francisconroy/NU-Racing---ETC-and-manumatic-Electronics/starkey/solenoid_driver-master/pcb/dual_half_bridge_driver/reminder_list.txt

-FUSES - 12v & (SMD and reverse polarity)
-1 or 2 drivers per board
-Heatsink orientation
-Connectors (footprint)
-Indicator LEDS
-Undervoltage lockout
