francisconroy/NU-Racing---ETC-and-manumatic-Electronics/pinout diagram.pptx

CU | OP

ECU5V
ECUGND
ECUTPS

ECU5V
ECUGND
ECUTPS
3V3
AGND
P17
3V3
AGND
P14
3V3
AGND
P15

BAT GND
BAT POS

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
P3 | P4

## Slide 2

P17 - SPARE | P18 - NEUT | GND

5V MOTEC
SIG MOTEC
GND MOTEC

P11 - UP
P12 - DN
GND

GND
P20 ROT 1
P21 ROT 2
P22 ROT 3
P23 MODE BTN

BV+
BGND

FLT NET
P19 SIG – TEMP1
P7 - UNUSED
P10 – 1INB
P9 – 1PWM
P8 – 1INA
GND
5V

FLT NET
P16 SIG – TEMP2
P2 - UNUSED
P5 – 2PWM
P4 – 2INB
P3 – 2INA
GND
5V

P6 - CLUTCH
GND

3V3
AGND
P14 - ANGLE

GND | P1 | P0
