francisconroy/NU-Racing---ETC-and-manumatic-Electronics/bill_of_materials2.xlsx

Sheet: Sheet1
IC's | Rating | Value | Quantity | Supplier | Ordering number | Price | Subtotal | Notes
gate driver |  | ir2114 | 2 | element14 | 1498177 | 5.71 | 11.42
mosfet |  | irfp1405pbf | 2 | element14 | 2062073 | 5.48 | 10.96 | AUIRFP1405Pbf (automotive rated)
mosfet | 80amp, 30v pmos | IPP80P03P4L-04 | 1 | element14 | 2443406 | 3.47 | 3.47 |  | Total
temp. sensor |  | lmt87 | 1 | element14 | 2432145 | 3.43 | 3.43 |  | 18985161.89
npn |  | MMBT2222ALT1G | 6 | element14 | 1459098 | 0.165 | 0.99
pnp |  | MMBT2907ALT1G | 5 | element14 | 1459099 | 0.165 | 0.825 |  | NOTES:
fuse | 0.5amp | 0437.500WR. | 2 | element14 | 1822807 | 0.52 | 1.04 | Ampage rating could possibly be lowered | Yellow implies to be filled
zener | 21v | SMAZ20-TP | 1 | element14 | 1924463 | 0.916 | 0.916 | D1 | All quantities need to be doubled
zener | 6v | 1SMA5920BT3G | 2 | element14 | 1431142 | 0.841 | 1.682 | D3,D2
zener | 10v | BZG03C10-TR | 1 | element14 | 6475802 | 0.634 | 0.634 | D7
regulator | 5v | KA7805ERTF | 1 | element14 | 1786484 | 1.5 | 1.5
pcb crimp tab | 6.35x0.81 | 726386-2 | 10 | element14 | 4215618 | 0.26 | 2.6
header | 10 way 0.1” | 1-640454-0 | 2 | element14 | 588544 | 0.879 | 1.758 | http://au.element14.com/te-connectivity-amp/1-640454-0/product-range-mta-100-series/dp/588544
header | 6 way 0.1” |  | 2 | element14 | 588611 | 0.56 | 1.12 | http://au.element14.com/te-connectivity-amp/640456-6/product-range-mta-100-series/dp/588611?ost=588611
connector | 6 way 0.1” |  | 2 | element14 | 1363277 | 0.73 | 1.46
connector | 10 way 0.1” | 4-643815-0 | 2 | element14 | 1296705 | 1.52 | 3.04
optocoupler | 4n25 | 4N25(SHORT) | 5 | element14 | 1225849 | 0.227 | 1.135
diodes | 40v, 3A schottky | SS34A | 3 | element14 | 1843500 | 0.431 | 1.293
Resistors |  |  |  |  |  |  | 0
270 | 1206 |  | 4 | element14 | 9336257 (http://au.element14.com/multicomp/mc0125w12061270r/resistor-270r-0-125w-1-1206/dp/9336257) |  | 0
330 | 1206 |  | 2 | element14 | 1632563 (http://au.element14.com/multicomp/mc1206s4f3300t5e/thick-film-resistor-330-ohm-250mw/dp/1632563) |  | 0
4.7k | 1206 |  | 4 | element14 | 1809484 (http://au.element14.com/koa-spear-electronics/rk73b2bttd472j/resistor-1206-4k7-ohm-5/dp/1809484) |  | 0
100 | 1206 |  | 2 | element14 | 1632521 (http://au.element14.com/multicomp/mc1206s4f1000t5e/thick-film-resistor-100-ohm-250mw/dp/1632521) |  | 0
22 | 1206 |  | 4 | element14 | 1152831 (http://au.element14.com/vishay-dale/crcw120622r0fkea/thick-film-resistor-22-ohm-250mw/dp/1152831) |  | 0
1k | 1206 |  | 9 | element14 | 1811972 (http://au.element14.com/koa-spear-electronics/rk73h2bttd1001f/resistor-1206-1k-ohm-1/dp/1811972) |  | 0
10k | 1206 |  | 8 | element14 | 1632523 (http://au.element14.com/multicomp/mc1206s4f1002t5e/thick-film-resistor-10kohm-250mw/dp/1632523) |  | 0
 |  |  |  |  |  |  | 0
Caps |  |  |  |  |  |  | 0
100n | 1206 | 12061C104KAT2A | 10 | element14 | 1327703 | 0.194 | 1.94 | actual qty 8, MOQ is 5
1n | 1206 | MC1206B102K202CT | 1 | element14 | 1855909 | 0.252 | 0.252
1u | 1206 | C3216X7R1E105K085AA | 3 | element14 | 2346954 | 0.08 | 0.24
0.68u | 250v | B32652A3684J000 | 1 | element14 | 1200778 | 1.86 | 1.86 | pulse rated
470n | 1206 | 12063C474KAT2A | 5 | element14 | 1327718 | 0.184 | 0.92 | MOQ is 5, actual qty 1
 |  |  |  |  |  |  | 0
Hardware |  |  |  |  |  |  | 0
mica pad | to-247 |  | 3 | element14 | 1577101 | 2.13 | 6.39
standoffs | M3x10 |  | 10 | element14 | 1898510 (http://au.element14.com/richco/htsa-m3-10-1/aluminium-spacer-f-f-m3-10mm-high/dp/1898510) | 0.272 | 18985100
screws | M3x20 |  | 3 | element14 | 1419295 (http://au.element14.com/tr-fastenings/m320-psstmcz100/screw-slt-pan-steel-bzp-m3x20/dp/1419295) |  | 0
screws | M3x6 |  | 4 | element14 | 1419986 |  | 0
insulated washer | M3.5 outer, M3 Inner | 7721-7PPSG | 3 | element14 | 1703100 | 0.337 | 1.011
nuts | M3 |  | 100 | element14 | 1419447

Sheet: output
PN | QTY | DESC | MULTIPLIER
 | 0 | Resistors |  | 0 | ',0,Resistors'
0 | 0 | 0 |  | 0 | '0,0,0'
0 | 0 | Caps |  | 0 | '0,0,Caps'
0 | 0 | 0 |  | 0 | '0,0,0'
0 | 0 | Hardware |  | 0 | '0,0,Hardware' | '
0 | 0 | 0 |  | 0 | '0,0,0'
0 | 0 | 0 |  | 0 | '0,0,0'
0 | 0 | 0 |  |  | '0,,0'
0 | 0 | 0
2443406 | 1 | mosfet | 2 | 2 | 2443406,2,mosfet
2432145 | 1 | temp. sensor | 2 | 2 | 2432145,2,temp. sensor
1924463 | 1 | zener | 2 | 2 | 1924463,2,zener
6475802 | 1 | zener | 2 | 2 | 6475802,2,zener
1786484 | 1 | regulator | 2 | 2 | 1786484,2,regulator
1855909 | 1 | 1n | 2 | 2 | 1855909,2,1n
1200778 | 1 | 0.68u | 2 | 2 | 1200778,2,0.68u
1498177 | 2 | gate driver | 2 | 4 | 1498177,4,gate driver
2062073 | 2 | mosfet | 2 | 4 | 2062073,4,mosfet
1822807 | 2 | fuse | 2 | 4 | 1822807,4,fuse
1431142 | 2 | zener | 2 | 4 | 1431142,4,zener
588544 | 2 | header | 2 | 4 | 588544,4,header
588611 | 2 | header | 2 | 4 | 588611,4,header
1363277 | 2 | connector | 2 | 4 | 1363277,4,connector
1296705 | 2 | connector | 2 | 4 | 1296705,4,connector
1632563 | 2 | 330 | 3 | 6 | 1632563,6,330
1632521 | 2 | 100 | 3 | 6 | 1632521,6,100
1843500 | 3 | diodes | 2 | 6 | 1843500,6,diodes
2346954 | 3 | 1u | 2 | 6 | 2346954,6,1u
1577101 | 3 | mica pad | 2 | 6 | 1577101,6,mica pad
1419295 | 3 | screws | 2 | 6 | 1419295,6,screws
1703100 | 3 | insulated washer | 2 | 6 | 1703100,6,insulated washer
9336257 | 4 | 270 | 3 | 12 | 9336257,12,270
1809484 | 4 | 4.7k | 3 | 12 | 1809484,12,4.7k
1152831 | 4 | 22 | 3 | 12 | 1152831,12,22
1419986 | 4 | screws | 2 | 8 | 1419986,8,screws
1459099 | 5 | pnp | 2 | 10 | 1459099,10,pnp
1225849 | 5 | optocoupler | 2 | 10 | 1225849,10,optocoupler
1327718 | 5 | 470n | 2 | 10 | 1327718,10,470n
1459098 | 6 | npn | 2 | 12 | 1459098,12,npn
1632523 | 8 | 10k | 3 | 24 | 1632523,24,10k
1811972 | 9 | 1k | 3 | 27 | 1811972,27,1k
4215618 | 10 | pcb crimp tab | 2 | 20 | 4215618,20,pcb crimp tab
1327703 | 10 | 100n | 2 | 20 | 1327703,20,100n
1898510 | 10 | standoffs | 2 | 20 | 1898510,20,standoffs
1419447 | 100 | nuts | 2 | 200 | 1419447,200,nuts
