francisconroy/NU-Racing---ETC-and-manumatic-Electronics/ETC_GS_Combined_BOM.xlsx

Sheet: pivot
Sum of qty
pkg | value | Total | TOTAL_REQ | ON_HAND | SUPPLIER# | PRICE PER UNIT | NOTE | SUPPLIER
1X10_LOCK | (blank) | 2 | 2 | 0 | 588544 | 0.915 | MTA-100 conn | E14
1X12_LOCK | P0-11 | 2 | 0
 | P12-23 | 2 | 0
C1206 | 0.1uF | 17 | 10 | 18 | 1867950 (http://au.element14.com/avx/12062c104kat2a/cap-mlcc-x7r-100nf-200v-1206/dp/1867950) | 0.036 |  | E14
 | 10n | 2 | 4 |  | 4801880 | 0.028 |  | E14
 | 1nF | 5 | 10 |  | 1759337 (http://au.element14.com/multicomp/mc1206b102k500ct/cap-mlcc-x7r-1nf-50v-1206/dp/1759337) | 0.074 |  | E14
 | 1uF | 2 | 4 |  | 1759438 | 0.018 |  | E14
DIP08 | LM358 | 1 | 2 |  | SF-COM-09456 | 1.46 | Through little bird elec | LittleBird
DISP_CONN | DISP_CONN | 1 | 1 |  | 588600 (http://au.element14.com/te-connectivity-amp/640456-5/product-range-mta-100-series/dp/588600) | 0.428 | display header | E14
DO214BA | 0 | 1 | 4 |  | 1687497 (http://au.element14.com/multicomp/1sma4740/diode-zener-10v-1w/dp/1687497) | 0.56 | 10V ZENER | E14
 | (blank) | 1
DO41-10 | 1N4004 | 1 | 2 |  | 1383892 (http://au.element14.com/nte-electronics/1n4004/standard-diode-1a-400v-do-41/dp/1383892) | 0.067 |  | E14
E5-8,5 | 47uF | 1 | 2 |  | 2346630 (http://au.element14.com/rubycon/200px47mefc10x20/product-range-px-series/dp/2346630) | 0.989 |  | E14
HSOP16-P-300-1.00 | TB6559FG | 1 | 0
JEDECDO-214AB | LNBTVS | 2 | 4 |  | 1749287 | 1.88 |  | E14
LED-1206 | FUSE HERE | 1 | 10 |  | 2414111 (http://au.element14.com/panasonic-electronic-components/erb-rg0r50v/fuse-500ma-63vdc-fast-acting-1206/dp/2414111) | 0.262 | FUSE 500mA for LM7805 | E14
M1206 | 2k | 1 | 2 |  | 2333590 | 0.1 |  | E14
 | 3k | 1 | 2 |  | 1646697 (http://au.element14.com/multicomp/mc1206s4f3001t5e/resistor-thick-film-3kohm-0-25w/dp/1646697) | 0.0034 |  | E14
MOLEX-1X3_LOCK | SER | 2 | 4 |  | 588581 (http://au.element14.com/te-connectivity-amp/640456-3/product-range-mta-100-series/dp/588581) | 0.331 | MTA-100 serial | E14
R1206 | 15 | 2 | 4 |  | 2332114 (http://au.element14.com/te-connectivity/crgh1206f15r/resistor-power-15r-0-5w-1-1206/dp/2332114) | 0.07 |  | E14
 | 27 | 2 | 4 |  | 2332118 (http://au.element14.com/te-connectivity/crgh1206f27r/resistor-power-27r-0-5w-1-1206/dp/2332118) | 0.07 |  | E14
 | 33 | 1 | 2 |  | 1692544 (http://au.element14.com/vishay-draloric/crcw120633r0fkea/product-range-aec-q200-crcw-series/dp/1692544) | 0.04 |  | E14
 | 39 | 2 | 4 |  | 2332120 (http://au.element14.com/te-connectivity/crgh1206f39r/resistor-power-39r-0-5w-1-1206/dp/2332120) | 0.07 |  | E14
 | 240 | 1 | 2 |  | 1630578 (http://au.element14.com/multicomp/mc1206s4f2400t5e/thick-film-resistor-240-ohm-250mw/dp/1630578) | 0.009 |  | E14
 | 270 | 6 | 12 |  | 1470003 (http://au.element14.com/vishay-draloric/crcw1206270rfkea/product-range-aec-q200-crcw-series/dp/1470003) | 0.04 |  | E14
 | 680 | 1 | 2 |  | 1632597 (http://au.element14.com/multicomp/mc1206s4f6800t5e/thick-film-resistor-680-ohm-250mw/dp/1632597) | 0.018 |  | E14
 | 10k | 15 | 30 |  | 1632523 (http://au.element14.com/multicomp/mc1206s4f1002t5e/thick-film-resistor-10kohm-250mw/dp/1632523) | 0.008 |  | E14
 | 1k | 8 | 16 |  | 1811972 (http://au.element14.com/koa-spear-electronics/rk73h2bttd1001f/resistor-1206-1k-ohm-1/dp/1811972) | 0.021 |  | E14
 | 20k | 6 | 12 |  | 1632543 (http://au.element14.com/multicomp/mc1206s4f2002t5e/thick-film-resistor-20kohm-250mw/dp/1632543) | 0.009 |  | E14
 | 4.7k | 7 | 14 |  | 1632579 (http://au.element14.com/multicomp/mc1206s4f4701t5e/thick-film-resistor-4-7kohm-250mw/dp/1632579) | 0.022 |  | E14
 | 40k | 2 | 4 |  | 2142268 (http://au.element14.com/multicomp/mc0125w1206140k2/resistor-40k2-0-125w-1-1206/dp/2142268) | 0.02 |  | E14
 | 56k | 1 | 2 |  | 1158086 (http://au.element14.com/vishay-dale/crcw120656k0fkea/thick-film-resistor-56kohm-250mw/dp/1158086) | 0.05 |  | E14
 | 9k1 | 1 | 2 |  | 1153324 (http://au.element14.com/vishay-dale/crcw12069k10fkea/thick-film-resistor-9-1kohm-250mw/dp/1153324) | 0.23 |  | E14
SO08 | ACS722 | 1 | 2 |  |  |  | PURCHASE THROUGH DIGIKEY - ALLEGRO ACS722LLCTR-05AB-T
SO08-2 | OPTOISOLATOR-2SOIC8 | 4 | 8 |  | 1045451 (http://au.element14.com/vishay/ild213t/optocoupler-smd-dual/dp/1045451) | 2.96 |  | E14
SO8STRETCH | ACPLC87BT | 2 | 4 |  | 2313197 | 22.63 |  | E14
SOT223 | V_REG_317SMD | 1 | 2 |  | 1652366 (http://au.element14.com/on-semiconductor/ncp1117st33t3g/ic-linear-voltage-regulator/dp/1652366) | 0.953 | FAN1117 SOT223 or sparkfun#COM-00595 | E14
SOT23-3 | NPN_TRAN | 6 | 12 |  | 1459098 (http://au.element14.com/on-semiconductor/mmbt2222alt1g/transistor-npn-40v-sot-23/dp/1459098) | 0.165 |  | E14
 | PNP_TRAN | 6 | 12 |  | 1459099 (http://au.element14.com/on-semiconductor/mmbt2907alt1g/transistor-bjt-pnp-60v-0-6a-sot/dp/1459099) | 0.165 |  | E14
SWITCH-SPDT_KIT | DIRTY 5V | 1 | 2 |  | 1524325 | 2.21 |  | E14
 | LOGIC POWER | 2 | 4 |  | 1524325 | 2.21 |  | E14
TEENSY31PAC | TEENSY31DEV | 2 | 0
TO220V | MOSFET-PCHANNELFQP27P06 | 2 | 4 |  | 9846530 | 2.67 |  | E14
TRACOPOWERDC-DCTRM2WIN | TRACOTMR2WIN | 2 | 3 |  | 1205065 | 25.3 | Alternate TMR 1211 | E14
W237-12P | 0 | 1 | 2 |  | 2315261 | 6.51 |  | E14
W237-132 | 0 | 5 | 12 |  | 2493625 (http://au.element14.com/camdenboss/ctb0709-2/terminal-block-wire-to-brd-2pos/dp/2493625) | 0.66 |  | E14
W237-133 | 0 | 5 | 12 |  | 2493626 (http://au.element14.com/camdenboss/ctb0709-3/terminal-block-wire-to-brd-3pos/dp/2493626) | 0.98 |  | E14
W237-5P | 0 | 1 | 0
ZDIO-7.5 | 7.5V | 1 | 1 |  | 4534633 | 0.188 |  | E14
(blank) | (blank)
Grand Total |  | 143 | 253
 |  |  | EXTRA
 |  |  | 4 |  | 1296705 | 1.58 | MTA-100 plug 26AWG | E14
 |  |  | 1 |  | AF-878 | 15.09 | Adafruit 0.56 4-Digit 7-Segment Display w/I2C Backpack - Red | LittleBird
 |  |  | 2 |  | 1098711 (http://au.element14.com/te-connectivity-amp/3-640442-3/housing-26awg-3way/dp/1098711) | 0.526 | MTA-100 plug 26AWG | E14
 |  |  | 2 |  | 1773007 (http://au.element14.com/te-connectivity-amp/3-643813-5/connector-mta-100-5way/dp/1773007) | 0.817 | MTA-100 plug 22AWG | E14
 |  |  | 3 |  | 1387715 (http://au.element14.com/pro-power/mcos5c24-ri-grey/cable-24awg-scrn-5core-per-m/dp/1387715) | 5.05 | 5 core display cable 22 AWG | E14
 |  |  | 2 |  | 1301033 (http://au.element14.com/amphenol-spectra-strip/135-2607-310/ribbon-cable-3c-10-core-per-m/dp/1301033) | 4.36 | 10 ribbon cable | E14

Sheet: combined
value | pkg | qty
33 | R1206 | 1
39 | R1206 | 2
240 | R1206 | 1
270 | R1206 | 5
680 | R1206 | 1
0.1uF | C1206 | 3
0.1uF | C1206 | 13
10k | R1206 | 5
10n | C1206 | 2
1k | R1206 | 6
1N4004 | DO41-10 | 1
1nF | C1206 | 5
1uF | C1206 | 2
20k | R1206 | 6
2k | M1206 | 1
3k | M1206 | 1
4.7k | R1206 | 5
40k | R1206 | 2
47uF | E5-8,5 | 1
4.7k | R1206 | 1
56k | R1206 | 1
7.5V | ZDIO-7.5 | 1
9k1 | R1206 | 1
ACPLC87BT | SO8STRETCH | 2
ACS722 | SO08 | 1
DIRTY 5V | SWITCH-SPDT_KIT | 1
DISP_CONN | DISP_CONN | 1
FUSE HERE | LED-1206 | 1
LM358 | DIP08 | 1
LNBTVS | JEDECDO-214AB | 1
LOGIC POWER | SWITCH-SPDT_KIT | 1
MOSFET-PCHANNELFQP27P06 | TO220V | 1
NPN_TRAN | SOT23-3 | 5
OPTOISOLATOR-2SOIC8 | SO08-2 | 3
P0-11 | 1X12_LOCK | 1
P12-23 | 1X12_LOCK | 1
PNP_TRAN | SOT23-3 | 5
SER | MOLEX-1X3_LOCK | 1
TB6559FG | HSOP16-P-300-1.00 | 1
TEENSY31DEV | TEENSY31PAC | 1
TRACOTMR2WIN | TRACOPOWERDC-DCTRM2WIN | 1
V_REG_317SMD | SOT223 | 1
(blank) | DO214BA | 1
0 | W237-12P | 1
0 | W237-132 | 3
0 | W237-133 | 1
15 | R1206 | 2
27 | R1206 | 2
270 | R1206 | 1
0.1uF | C1206 | 1
10k | R1206 | 10
1k | R1206 | 2
4.7k | R1206 | 1
LNBTVS | JEDECDO-214AB | 1
LOGIC POWER | SWITCH-SPDT_KIT | 1
MOSFET-PCHANNELFQP27P06 | TO220V | 1
NPN_TRAN | SOT23-3 | 1
OPTOISOLATOR-2SOIC8 | SO08-2 | 1
P0-11 | 1X12_LOCK | 1
P12-23 | 1X12_LOCK | 1
PNP_TRAN | SOT23-3 | 1
SER | MOLEX-1X3_LOCK | 1
TEENSY31DEV | TEENSY31PAC | 1
TRACOTMR2WIN | TRACOPOWERDC-DCTRM2WIN | 1
(blank) | 1X10_LOCK | 2
0 | DO214BA | 1
0 | W237-132 | 2
0 | W237-133 | 4
0 | W237-5P | 1
 |  | 143

Sheet: RS order
name | value | orderqty | supp# | ppu | note | supp
1X10_LOCK | (blank) | 2 | 588544 | 0.915 | MTA-100 conn | E14 | 588544,2,1X10_LOCK(blan
C1206 | 0.1uF | 10 | 1867950 | 0.036 |  | E14 | 1867950,10,C12060.1uF
 | 10n | 4 | 4801880 | 0.028 |  | E14 | 4801880,4,10n
 | 1nF | 10 | 1759337 | 0.074 |  | E14 | 1759337,10,1nF
 | 1uF | 4 | 1759438 | 0.018 |  | E14 | 1759438,4,1uF
DIP08 | LM358 | 2 | SF-COM-09456 | 1.46 | Through little bird elec | LittleBird
DISP_CONN | DISP_CONN | 1 | 588600 | 0.428 | display header | E14 | 588600,1,DISP_CONNDISP_
DO214BA | 0 | 4 | 1687497 | 0.56 | 10V ZENER | E14 | 1687497,4,DO214BA0
DO41-10 | 1N4004 | 2 | 1383892 | 0.067 |  | E14 | 1383892,2,DO41-101N400
E5-8,5 | 47uF | 2 | 2346630 | 0.989 |  | E14 | 2346630,2,E5-8,547uF
JEDECDO-214AB | LNBTVS | 4 | 1749287 | 1.88 |  | E14 | 1749287,4,JEDECDO-214ABLNBTV
LED-1206 | FUSE HERE | 10 | 2414111 | 0.262 | FUSE 500mA for LM7805 | E14 | 2414111,10,LED-1206FUSE
M1206 | 2k | 2 | 2333590 | 0.1 |  | E14 | 2333590,2,M12062k
 | 3k | 2 | 1646697 | 0.0034 |  | E14 | 1646697,2,3k
MOLEX-1X3_LOCK | SER | 4 | 588581 | 0.331 | MTA-100 serial | E14 | 588581,4,MOLEX-1X3_LOCKSER
R1206 | 15 | 4 | 2332114 | 0.07 |  | E14 | 2332114,4,R120615
 | 27 | 4 | 2332118 | 0.07 |  | E14 | 2332118,4,27
 | 33 | 2 | 1692544 | 0.04 |  | E14 | 1692544,2,33
 | 39 | 4 | 2332120 | 0.07 |  | E14 | 2332120,4,39
 | 240 | 2 | 1630578 | 0.009 |  | E14 | 1630578,2,240
 | 270 | 12 | 1470003 | 0.04 |  | E14 | 1470003,12,270
 | 680 | 2 | 1632597 | 0.018 |  | E14 | 1632597,2,680
 | 10k | 30 | 1632523 | 0.008 |  | E14 | 1632523,30,10k
 | 1k | 16 | 1811972 | 0.021 |  | E14 | 1811972,16,1k
 | 20k | 12 | 1632543 | 0.009 |  | E14 | 1632543,12,20k
 | 4.7k | 14 | 1632579 | 0.022 |  | E14 | 1632579,14,4.7k
 | 40k | 4 | 2142268 | 0.02 |  | E14 | 2142268,4,40k
 | 56k | 2 | 1158086 | 0.05 |  | E14 | 1158086,2,56k
 | 9k1 | 2 | 1153324 | 0.23 |  | E14 | 1153324,2,9k1
SO08 | ACS722 | 2 |  |  | PURCHASE THROUGH DIGIKEY - ALLEGRO ACS722LLCTR-05AB-T | digikey
SO08-2 | OPTOISOLATOR-2SOIC8 | 8 | 1045451 | 2.96 |  | E14 | 1045451,8,SO08-2OPTOI
SO8STRETCH | ACPLC87BT | 4 | 2313197 | 22.63 |  | E14 | 2313197,4,SO8STRETCHACPLC
SOT223 | V_REG_317SMD | 2 | 1652366 | 0.953 | FAN1117 SOT223 or sparkfun#COM-00595 | E14 | 1652366,2,SOT223V_REG
SOT23-3 | NPN_TRAN | 12 | 1459098 | 0.165 |  | E14 | 1459098,12,SOT23-3NPN_T
 | PNP_TRAN | 12 | 1459099 | 0.165 |  | E14 | 1459099,12,PNP_T
SWITCH-SPDT_KIT | DIRTY 5V | 2 | 1524325 | 2.21 |  | E14 | 1524325,2,SWITCH-SPDT_KITDIRTY
 | LOGIC POWER | 4 | 1524325 | 2.21 |  | E14 | 1524325,4,LOGIC
TO220V | MOSFET-PCHANNELFQP27P06 | 4 | 9846530 | 2.67 |  | E14 | 9846530,4,TO220VMOSFE
TRACOPOWERDC-DCTRM2WIN | TRACOTMR2WIN | 3 | 1205065 | 25.3 | Alternate TMR 1211 | E14 | 1205065,3,TRACOPOWERTRACO
W237-12P | 0 | 2 | 2315261 | 6.51 |  | E14 | 2315261,2,W237-12P0
W237-132 | 0 | 12 | 2493625 | 0.66 |  | E14 | 2493625,12,W237-1320
W237-133 | 0 | 12 | 2493626 | 0.98 |  | E14 | 2493626,12,W237-1330
W237-5P | 0 | 0
ZDIO-7.5 | 7.5V | 1 | 4534633 | 0.188 |  | E14 | 4534633,1,ZDIO-7.57.5V
 |  | 4 | 1296705 | 1.58 | MTA-100 plug 26AWG | E14 | 1296705,4,
 |  | 1 | AF-878 | 15.09 | Adafruit 0.56 4-Digit 7-Segment Display w/I2C Backpack - Red | LittleBird
 |  | 2 | 1098711 | 0.526 | MTA-100 plug 26AWG | E14 | 1098711,2,
 |  | 2 | 1773007 | 0.817 | MTA-100 plug 22AWG | E14 | 1773007,2,
 |  | 3 | 1387715 | 5.05 | 5 core display cable 22 AWG | E14 | 1387715,3,
 |  | 2 | 1301033 | 4.36 | 10 ribbon cable | E14 | 1301033,2,

Sheet: RS simplified
588544,2,1X10_LOCK(blan
1867950,10,C12060.1uF
4801880,4,10n
1759337,10,1nF
1759438,4,1uF
588600,1,DISP_CONNDISP_
1687497,4,DO214BA0
1383892,2,DO41-101N400
2346630,2,E5-8,547uF
1749287,4,JEDECDO-214ABLNBTV
2414111,10,LED-1206FUSE
2333590,2,M12062k
1646697,2,3k
588581,4,MOLEX-1X3_LOCKSER
2332114,4,R120615
2332118,4,27
1692544,2,33
2332120,4,39
1630578,2,240
1470003,12,270
1632597,2,680
1632523,30,10k
1811972,16,1k
1632543,12,20k
1632579,14,4.7k
2142268,4,40k
1158086,2,56k
1153324,2,9k1
1045451,8,SO08-2OPTOI
2313197,2,SO8STRETCHACPLC
1652366,2,SOT223V_REG
1459098,12,SOT23-3NPN_T
1459099,12,PNP_T
1524325,2,SWITCH-SPDT_KITDIRTY
1524325,4,LOGIC
9846530,4,TO220VMOSFE
1205065,2,TRACOPOWERTRACO
2315261,2,W237-12P0
2493625,12,W237-1320
2493626,12,W237-1330
4534633,1,ZDIO-7.57.5V
1296705,4,
1098711,2,
1773007,2,
1387715,3,
1301033,2,
