francisconroy/NU-Racing---ETC-and-manumatic-Electronics/starkey/solenoid_driver-master/BOM.xlsx

Sheet: driver (Autosaved)
Row Labels
0
R1
R17
R2
R4
20
R24
R25
R28
R29
100
R26
R30
270
R13
R14
R15
R18
330
R34
R37
7805
U1
100n
C1
C11
C4
C6
C7
C8
C9
10k
R10
R11
R16
R3
R31
R33
R5
R9
1k
R19
R20
R21
R22
R23
R27
R32
R35
R36
1n
C5
1u
C2
C3
330n
C12
C13
4.7k
R12
R6
R7
R8
470n
C10
4N25
U3
U4
U5
U6
CONN_01X02
P4
P5
CONN_01X03
P2
P3
CONN_01X06
P6
CONN_01X10
P1
DIODESCH
D4
D5
D6
FUSE
F1
F2
IRS2114
U2
Q_NMOS_GDS
Q10
Q9
Q_NPN_BEC
Q1
Q11
Q13
Q2
Q3
Q7
Q_PMOS_GDS
Q12
Q_PNP_BEC
Q14
Q4
Q5
Q6
Q8
ZENER
D1
D2
D3
D7
(blank)
(blank)
Grand Total

Sheet: driver
Reference | Value | Footprint | Datasheet
U2 | IRS2114 | Housings_SSOP:SSOP-24_5.3x8.2mm_Pitch0.65mm
D5 | DIODESCH | SMD_Packages:SMD-1206_Pol
D4 | DIODESCH | SMD_Packages:SMD-1206_Pol
C10 | 470n | Capacitors_SMD:C_1206_HandSoldering
R23 | 1k | Resistors_SMD:R_1206_HandSoldering
R24 | 20 | Resistors_SMD:R_1206_HandSoldering
R25 | 20 | Resistors_SMD:R_1206_HandSoldering
R28 | 20 | Resistors_SMD:R_1206_HandSoldering
R29 | 20 | Resistors_SMD:R_1206_HandSoldering
R27 | 1k | Resistors_SMD:R_1206_HandSoldering
D6 | DIODESCH | SMD_Packages:SMD-1206_Pol
C6 | 100n | Capacitors_SMD:C_1206_HandSoldering
C5 | 1n | Capacitors_SMD:C_1206_HandSoldering
Q9 | Q_NMOS_GDS | Transistors_TO-247:TO-247_Vertical_Neutral123
Q10 | Q_NMOS_GDS | Transistors_TO-247:TO-247_Vertical_Neutral123
R17 | 0 | Resistors_SMD:R_1206_HandSoldering
P4 | CONN_01X02 | Pin_Headers:Pin_Header_Straight_1x02
C13 | 330n | Capacitors_ThroughHole:C_Rect_L18_W6_H12_P15
C12 | 330n | Capacitors_ThroughHole:C_Rect_L32_W15_P27
C7 | 100n | Capacitors_SMD:C_1206_HandSoldering
R19 | 1k | Resistors_SMD:R_1206_HandSoldering
U1 | 7805 | Diodes_SMD:D-Pak_TO252AA
C2 | 1u | Capacitors_SMD:C_1206_HandSoldering
C3 | 1u | Capacitors_SMD:C_1206_HandSoldering
C1 | 100n | Capacitors_SMD:C_1206_HandSoldering
P1 | CONN_01X10 | Pin_Headers:Pin_Header_Straight_1x10
C4 | 100n | Capacitors_SMD:C_1206_HandSoldering
R30 | 100 | Resistors_SMD:R_1206_HandSoldering
R26 | 100 | Resistors_SMD:R_1206_HandSoldering
R13 | 270 | Resistors_SMD:R_1206_HandSoldering
R6 | 4.7k | Resistors_SMD:R_1206_HandSoldering
C8 | 100n | Capacitors_SMD:C_1206_HandSoldering
R20 | 1k | Resistors_SMD:R_1206_HandSoldering
R14 | 270 | Resistors_SMD:R_1206_HandSoldering
R7 | 4.7k | Resistors_SMD:R_1206_HandSoldering
C9 | 100n | Capacitors_SMD:C_1206_HandSoldering
R21 | 1k | Resistors_SMD:R_1206_HandSoldering
R15 | 270 | Resistors_SMD:R_1206_HandSoldering
R8 | 4.7k | Resistors_SMD:R_1206_HandSoldering
R5 | 10k | Resistors_SMD:R_1206_HandSoldering
R3 | 10k | Resistors_SMD:R_1206_HandSoldering
C11 | 100n | Capacitors_SMD:C_1206_HandSoldering
R18 | 270 | Resistors_SMD:R_1206_HandSoldering
R12 | 4.7k | Resistors_SMD:R_1206_HandSoldering
D1 | ZENER | SMD_Packages:SMD-1206_Pol
F1 | FUSE | Resistors_SMD:R_1206_HandSoldering
D2 | ZENER | SMD_Packages:SMD-1206_Pol
D3 | ZENER | SMD_Packages:SMD-1206_Pol
F2 | FUSE | Resistors_SMD:R_1206_HandSoldering
R22 | 1k | Resistors_SMD:R_1206_HandSoldering
R16 | 10k | Resistors_SMD:R_1206_HandSoldering
R11 | 10k | Resistors_SMD:R_1206_HandSoldering
U6 | 4N25 | Housings_DIP:DIP-6_W7.62mm
U3 | 4N25 | Housings_DIP:DIP-6_W7.62mm
U4 | 4N25 | Housings_DIP:DIP-6_W7.62mm
U5 | 4N25 | Housings_DIP:DIP-6_W7.62mm
Q12 | Q_PMOS_GDS | Transistors_TO-220:TO-220_Neutral123_Vertical
D7 | ZENER | SMD_Packages:SMD-1206_Pol
R32 | 1k | Resistors_SMD:R_1206_HandSoldering
R36 | 1k | Resistors_SMD:R_1206_HandSoldering
R37 | 330 | Resistors_SMD:R_1206_HandSoldering
R4 | 0 | Resistors_SMD:R_1206_HandSoldering
P2 | CONN_01X03 | Pin_Headers:Pin_Header_Straight_1x03
R35 | 1k | Resistors_SMD:R_1206_HandSoldering
R1 | 0 | Resistors_SMD:R_1206_HandSoldering
R2 | 0 | Resistors_SMD:R_1206_HandSoldering
R31 | 10k | Resistors_SMD:R_1206_HandSoldering
R33 | 10k | Resistors_SMD:R_1206_HandSoldering
R34 | 330 | Resistors_SMD:R_1206_HandSoldering
P6 | CONN_01X06 | Pin_Headers:Pin_Header_Straight_1x06
P3 | CONN_01X03 | Pin_Headers:Pin_Header_Straight_1x03
P5 | CONN_01X02 | Crimp_Connector_2
R9 | 10k | Resistors_SMD:R_1206_HandSoldering
R10 | 10k | Resistors_SMD:R_1206_HandSoldering
Q7 | Q_NPN_BEC | Housings_SOT-23_SOT-143_TSOT-6:SOT-23_Handsoldering
Q1 | Q_NPN_BEC | Housings_SOT-23_SOT-143_TSOT-6:SOT-23_Handsoldering
Q2 | Q_NPN_BEC | Housings_SOT-23_SOT-143_TSOT-6:SOT-23_Handsoldering
Q3 | Q_NPN_BEC | Housings_SOT-23_SOT-143_TSOT-6:SOT-23_Handsoldering
Q11 | Q_NPN_BEC | Housings_SOT-23_SOT-143_TSOT-6:SOT-23_Handsoldering
Q13 | Q_NPN_BEC | Housings_SOT-23_SOT-143_TSOT-6:SOT-23_Handsoldering
Q14 | Q_PNP_BEC | Housings_SOT-23_SOT-143_TSOT-6:SOT-23_Handsoldering
Q6 | Q_PNP_BEC | Housings_SOT-23_SOT-143_TSOT-6:SOT-23_Handsoldering
Q5 | Q_PNP_BEC | Housings_SOT-23_SOT-143_TSOT-6:SOT-23_Handsoldering
Q4 | Q_PNP_BEC | Housings_SOT-23_SOT-143_TSOT-6:SOT-23_Handsoldering
Q8 | Q_PNP_BEC | Housings_SOT-23_SOT-143_TSOT-6:SOT-23_Handsoldering
