francisconroy/NU-Racing---ETC-and-manumatic-Electronics/GS module pin usage.xlsx

Sheet: pins
LABELLED PIN | SOFTWARE PIN | DIR | NAME | NOTE | CONN | NOTE 2
0 | PTB16 | IO | RX1 | UART1
1 | PTB17 | IO | TX1 | UART1
2 | PTD0 | O
3 | PTA12 | O | 2INA | toms driver
4 | PTA13 | O | 2INB | toms driver
5 | PTD7 | O | 2PWM | toms driver
6 | PTD4 | IO | CLUTCH SW
7 | PTD2 | O
8 | PTD3 | O | 1INA | toms driver
9 | PTC3 | O | 1PWM | toms driver
10 | PTC4 | O | 1INB | toms driver
11 | PTC6 | I | SH_UP | switch on wheel to shift up - SHIFT 3
12 | PTC7 | I | SH_DN | switch on wheel to shift dn - SHIFT 2
13 | PTC5 | I | MOTEC_GEAR_SIGNAL | OUTPUT AS A PWM SIGNAL FROM JOSH
14 | PTD1 | I | SHIFT_LEVER_ANGLE | SHIFT LEVER POT
15 | PTC0
16 | PTB0 | I | TEMP2
17 | PTB1 | I | SPARE_SW
18 | PTB3 | I | NEUT_SW | switch to shift to neutral
19 | PTB2 | I | TEMP1
20 | PTD5 | I | ROT_SW_P1 | SIG TO PIN 1,7 |  | MODE_SEL 4
21 | PTD6 | I | ROT_SW_P2 | SIG TO PIN 2,8 |  | MODE_SEL 3
22 | PTC1 | I | ROT_SW_P3 | SIG TO PIN 3,9 |  | MODE_SEL 2
23 | PTC2 | I | MODE_ENG | MODE ENGAGE |  | MODE_SEL 1
 |  |  | Need clutch switch | clutch engage before shift into neutral

Sheet: pin_mapping
TEENSY PINS | uC PINS
0 | PTB16
1 | PTB17
2 | PTD0
3 | PTA12
4 | PTA13
5 | PTD7
6 | PTD4
7 | PTD2
8 | PTD3
9 | PTC3
10 | PTC4
11 | PTC6
12 | PTC7
13 | PTC5
14 | PTD1
15 | PTC0
16 | PTB0
17 | PTB1
18 | PTB3
19 | PTB2
20 | PTD5
21 | PTD6
22 | PTC1
23 | PTC2

Sheet: calculations
TEMP SENSOR
R1 | 15
R2 | 27
Vin | 5
Vout | 3.214285714

Sheet: board_dimension
2.65 | 67.31
3.2 | 81.28
 | 0
 | 0
4 | 101.6
3.2 | 81.28

Sheet: BOM
Partlist
Exported fro | m GS_module.brd at 1/09/ | 2015 9:18
EAGLE Versio | n 7.3.0 Copyright (c) 19 | 88-2015 CadSoft
Assembly var | iant:
Part | Value | Package | Library | Position (inch) | Orientation
10VZENER |  | DO214BA | diode | (0.3 0.85) | MR90
BAT_CONN |  | W237-132 | con-wago-508 | (0.2 1.425) | R270
C1 | 0.1uF | C1206 | resistor | (1.125 0.7) | MR180
CLUTCH_SW |  | W237-132 | con-wago-508 | (2.45 1.25) | R90
ENDSTOPS |  | W237-133 | con-wago-508 | (0.85 3) | R180
GSENDSTOP |  | W237-133 | con-wago-508 | (2.45 0.7) | R90
JP1 | P0-11 | 1X12_LOCK | SparkFun-Connectors | (1.7 0.8) | R90
JP2 | P12-23 | 1X12_LOCK | SparkFun-Connectors | (0.8 1) | R90
JP3 | SER | MOLEX-1X3_LOCK | SparkFun-Connectors | (1.65 0.3) | R180
MODE_SEL |  | W237-5P | con-wago-508 | (0.175 2.15) | R90
MOTECSIGNAL |  | W237-133 | con-wago-508 | (2.45 2.85) | R270
Q2 | MOSFET-PCHANNELFQP27P06 | TO220V | SparkFun-DiscreteSemi | (0.225 1.075) | R180
R1 | 27 | R1206 | rcl | (1.825 0.825) | MR90
R2 | 27 | R1206 | rcl | (1.8 1.975) | MR90
R3 | 15 | R1206 | rcl | (1.825 1.05) | MR90
R4 | 15 | R1206 | rcl | (1.8 2.2) | MR90
R5 | 1k | R1206 | rcl | (0.35 1.3) | MR90
R6 | 270 | R1206 | resistor | (1.9 2.85) | MR90
R7 | 10k | R1206 | resistor | (1.5 2.85) | R270
R8 | 4.7k | R1206 | resistor | (2.05 2.7) | R0
R9 | 1k | R1206 | resistor | (1.4 2.2) | MR0
R10 | 10k | R1206 | rcl | (2.25 2.35) | MR270
R11 | 10k | R1206 | rcl | (2.25 2.075) | MR270
R12 | 10k | R1206 | rcl | (0.65 2.7) | MR270
R13 | 10k | R1206 | rcl | (0.85 2.7) | MR270
R14 | 10k | R1206 | rcl | (0.45 2.35) | MR180
R15 | 10k | R1206 | rcl | (0.45 2.15) | MR180
R16 | 10k | R1206 | rcl | (0.45 1.95) | MR180
R17 | 10k | R1206 | rcl | (0.45 1.75) | MR180
R18 | 10k | R1206 | rcl | (2.25 1.4) | MR90
S1 | LOGIC POWER | SWITCH-SPDT_KIT | SparkFun-Electromechanical | (0.6 0.3) | R0
SHIFT |  | W237-133 | con-wago-508 | (2.45 2.15) | R90
SOLDVR1 |  | 1X10_LOCK | SparkFun-Connectors | (1.95 1.2) | R270
SOLDVR2 |  | 1X10_LOCK | SparkFun-Connectors | (1.95 2.35) | R270
U$1 | TEENSY31DEV | TEENSY31PAC | custom | (1.3 1.35) | R90
U$3 | NPN_TRAN | SOT23-3 | custom | (1.65 2.7) | R0
U$4 | PNP_TRAN | SOT23-3 | custom | (1.65 2.95) | R180
U$5 | TRACOTMR2WIN | TRACOPOWERDC-DCTRM2WIN | custom | (0.15 0.475) | R270
U$6 | LNBTVS | JEDECDO-214AB | custom | (0.55 0.75) | R270
U$17 | OPTOISOLATOR-2SOIC8 | SO08-2 | SparkFun-DiscreteSemi | (1.6 2.4) | R180
