francisconroy/NU-Racing---ETC-and-manumatic-Electronics/(list of files, cad)

Other CAD files:
WIRING/ETC_teensy.dwg
