francisconroy/NU-Racing---ETC-and-manumatic-Electronics/wiring_connections.xlsx

Sheet: conns
 | EXT?? | NOTES | TERMINATION (MODULE) | TERMINATION (OTHER END)
GS MODULE
BATTERY GND | 1 | LO CURRENT, FOR 5V
BATTERY POS | 1 | LO CURRENT, FOR 5V
MOTEC SENSOR 5V | 1 | Gear signal
MOTEC SENSOR 0V | 1 | Gear signal
MOTEC AUX OUTPUT | 1 | Gear signal
SOLENOID DRIVER 1
BATTERY GND | 1 | HIGH CURRENT! - FROM BATT
BATTERY POS | 1 | HIGH CURRENT! - FROM BATT
SOLENOID POW | 1 | HIGH CURRENT! - OUT TO SOLENOID |  | 45A FUSE
SOLENOID GND | 1 | HIGH CURRENT! - OUT TO SOLENOID
SOLENOID DRIVER 2
BATTERY GND | 1 | HIGH CURRENT! - FROM BATT
BATTERY POS | 1 | HIGH CURRENT! - FROM BATT
SOLENOID POW | 1 | HIGH CURRENT! - OUT TO SOLENOID |  | 45A FUSE
SOLENOID GND | 1 | HIGH CURRENT! - OUT TO SOLENOID
ETC MODULE
TPS A SIGNAL - TO ECU | 1 | THIS SIGNAL PASSES THROUGH ETC MODULE | SCREW TERMINAL | ECU CONNECTOR
TPS A ECU - GROUND | 1 | THIS SIGNAL PASSES THROUGH ETC MODULE | SCREW TERMINAL | ECU CONNECTOR
TPS A ECU - POWER (5V) | 1 | THIS SIGNAL PASSES THROUGH ETC MODULE | SCREW TERMINAL | ECU CONNECTOR
TPS A SIGNAL - TO TPS | 1 | THIS SIGNAL PASSES THROUGH ETC MODULE | SCREW TERMINAL | BOSCH TPS CONNECTOR
TPS A ECU - GROUND | 1 | THIS SIGNAL PASSES THROUGH ETC MODULE | SCREW TERMINAL | BOSCH TPS CONNECTOR
TPS A ECU - POWER (5V) | 1 | THIS SIGNAL PASSES THROUGH ETC MODULE | SCREW TERMINAL | BOSCH TPS CONNECTOR
BATTERY GROUND | 1 |  | SCREW TERMINAL | unspec
BATTERY POSITIVE | 1 | DOES NOT NEED TO BE 12V Exactly - 2A | SCREW TERMINAL | unspec

Sheet: connectors
CONNECTORS |  | TYPE | DEST |  | MODULE | DEUTSCH CONTACT SIZE | POSS CONS | L
ET | 1 | DTM | VALVE | AGND | ETC | Size 20
ET | 2 | DTM | VALVE | 3.3V | ETC | Size 20
ET | 3 | DTM | VALVE | TPSB | ETC | Size 20
ET | 4 | DTM | VALVE | ECU GND | ETC | Size 20
ET | 5 | DTM | VALVE | ECU 5V | ETC | Size 20
ET | 6 | DTM | VALVE | TPSA | ETC | Size 20
ET | 7 | DTM | VALVE | MOT A | ETC | Size 20
ET | 8 | DTM | VALVE | MOT B | ETC | Size 20
ET | 9 | DTM | ECU | ECU GND | ETC | Size 20
ET | 10 | DTM | ECU | ECU 5V | ETC | Size 20
ET | 11 | DTM | ECU | TPSA | ETC | Size 20
ET | 12 | DTM | PEDAL | APPSB | ETC | Size 20
GE | 1 | DTM | PEDAL | AGND | ETC | Size 20
GE | 2 | DTM | PEDAL | 3.3V | ETC | Size 20
GE | 3 | DTM | PEDAL | APPSA | ETC | Size 20
GE | 4 | DTM | CAN | CAN H | ETC | Size 20 |  | c | 1500 | GREY
GE | 5 | DTM | CAN | CAN L | ETC | Size 20 |  | c | 1500 | GREY
GE | 6 | DTM | POWER | BATT GND | ETC/GS | Size 20 |  | c | 1500 | BLK
GE | 7 | DTM | POWER | BATT POS | ETC/GS | Size 20 |  | c | 1500 | RED
GE | 8 | DTM | SOLEN_ANG | AGND | GS | Size 20 |  | b | 1000 | BRN
GE | 9 | DTM | SOLEN_ANG | 3.3V | GS | Size 20 |  | b | 1000 | GRN
GE | 10 | DTM | SOLEN_ANG | APPSA | GS | Size 20 |  | b | 1000 | GREY
GE | 11 | DTM | MODE_KN | MODE_SET | GS | Size 20 |  | a | 3000 | GREY
GE | 12 | DTM | MODE_KN | 1 | GS | Size 20 |  | a | 3000 | GREY
GS | 1 | DTM | MODE_KN | 2 | GS | Size 20 |  | a | 3000 | GREY
GS | 2 | DTM | MODE_KN | 3 | GS | Size 20 |  | a | 3000 | GREY
GS | 3 | DTM | MODE_KN | GND | GS | Size 20 |  | a | 3000 | BRN
GS | 4 | DTM | CLUTCHSW | SW | GS | Size 20 |  |  | 2000 | GREY
GS | 5 | DTM | CLUTCHSW | GND | GS | Size 20 |  |  | 2000 | BRN
GS | 6 | DTM | SHIFT | GND | GS | Size 20 |  | a | 3000 | BRN
GS | 7 | DTM | SHIFT | UP | GS | Size 20 |  | a | 3000 | GREY
GS | 8 | DTM | SHIFT | NEUT | GS | Size 20 |  | a | 3000 | Split | Additional DS button on clutch post
GS | 9 | DTM | SHIFT | DN | GS | Size 20 |  | a | 3000 | Split | Additional DS button on clutch post
GS | 10 | DTM | Motec | MOTEC SENSOR 5V | GS | Size 20 |  | c | 1500 | BLUE
GS | 11 | DTM | Motec | MOTEC SENSOR 0V | GS | Size 20 |  | c | 1500 | BRN
GS | 12 | DTM | Motec | MOTEC AUX OUTPUT | GS | Size 20 |  | c | 1500
PH | 1 | DTHD | SOLEN A | HI CURR | SOLEN | Size 8 |  | b | 1000 | RED
PH | 2 | DTHD | SOLEN GND | HI CURR | SOLEN | Size 8 |  | b | 1000 | BLK
PH | 3 | DTHD | SOLEN B | HI CURR | SOLEN | Size 8 |  | b | 1000 | RED
PH | 4 | DTHD
PH | 5
PH | 6 | DTHD | BATTV+ | HI CURR | SOLEN | Size 8 | 45A FUSE | b | 1000 | RED
PH | 7 | DTHD | BATTV- | HI CURR | SOLEN | Size 8 |  | b | 1000 | BLK
PH | 8 | DTHD
D | 9 | DTHD

Sheet: LOOKUP
a | 3000
b | 1000
c | 1500
