francisconroy/NU-Racing---ETC-and-manumatic-Electronics/starkey/solenoid_driver-master/pcb/dual_half_bridge_driver/driver.pdf

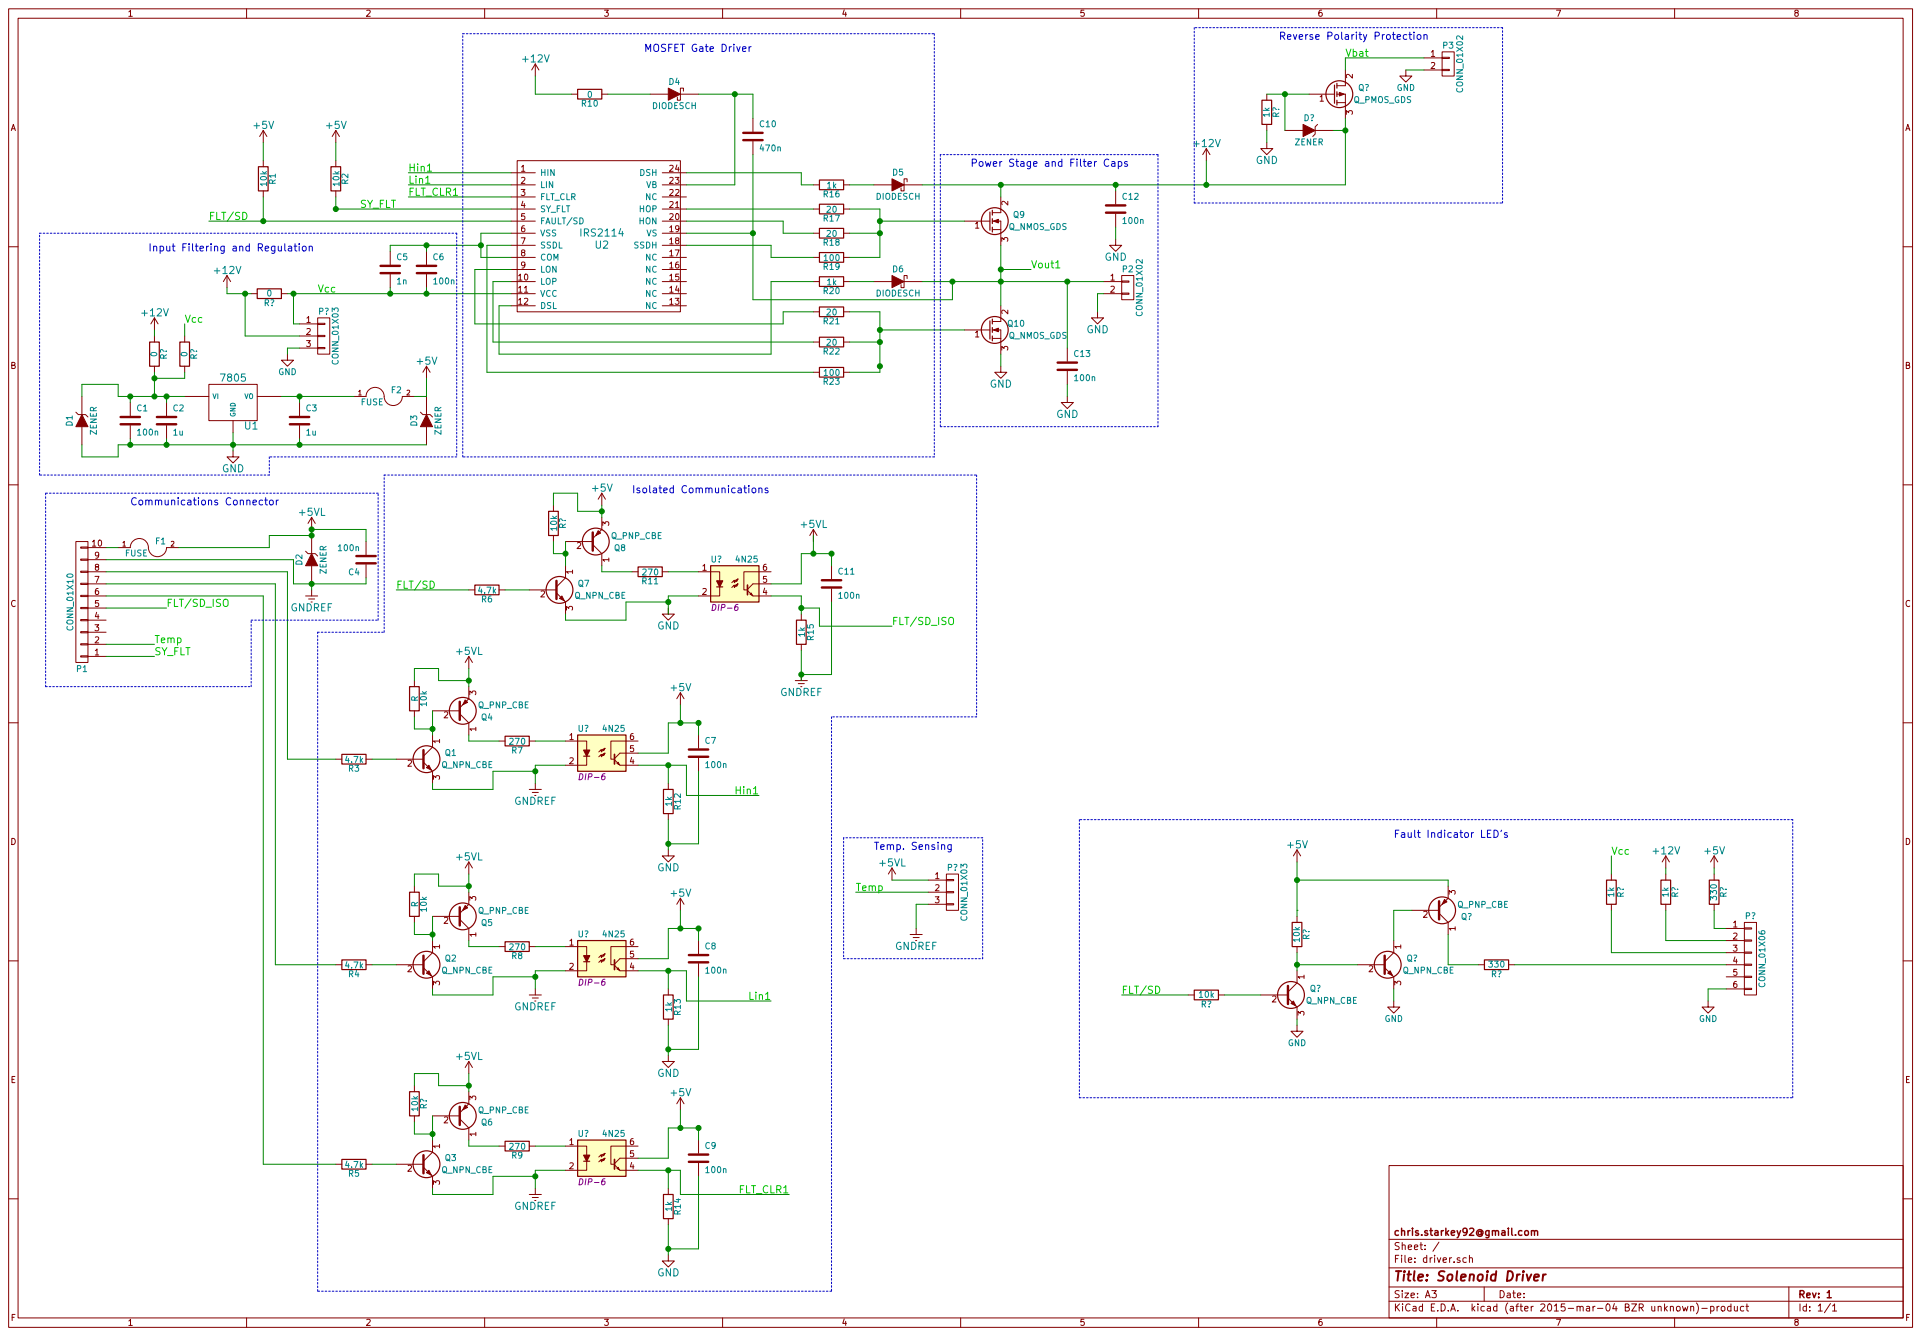
[picture p1: page 1]

Power Stage and Filter Caps

Input Filtering and Regulation

Id: 1/1 Title: Solenoid Driver File: driver.sch Sheet: / chris.starkey92@gmail.com
