francisconroy/NU-Racing---ETC-and-manumatic-Electronics/eagle/project/ETC_module.pdf

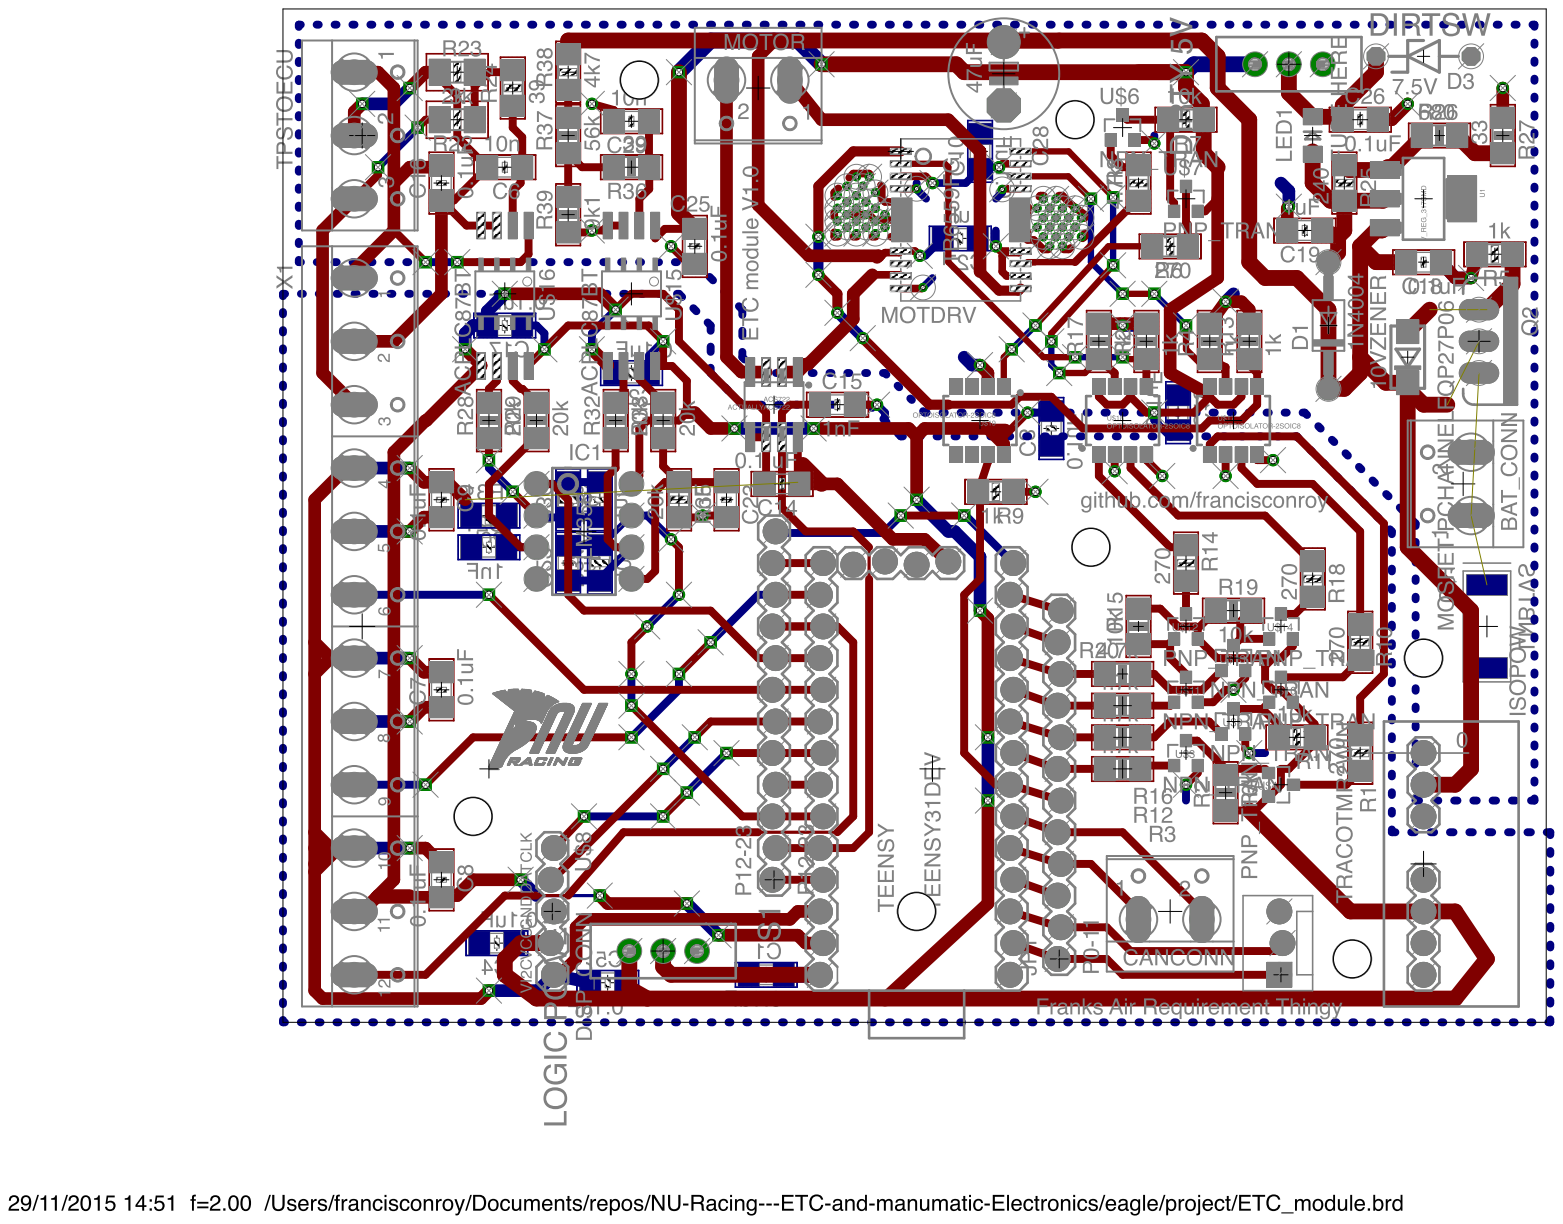
[picture p2: page 1]
