francisconroy/NU-Racing---ETC-and-manumatic-Electronics/eagle/project/GS_module.pdf

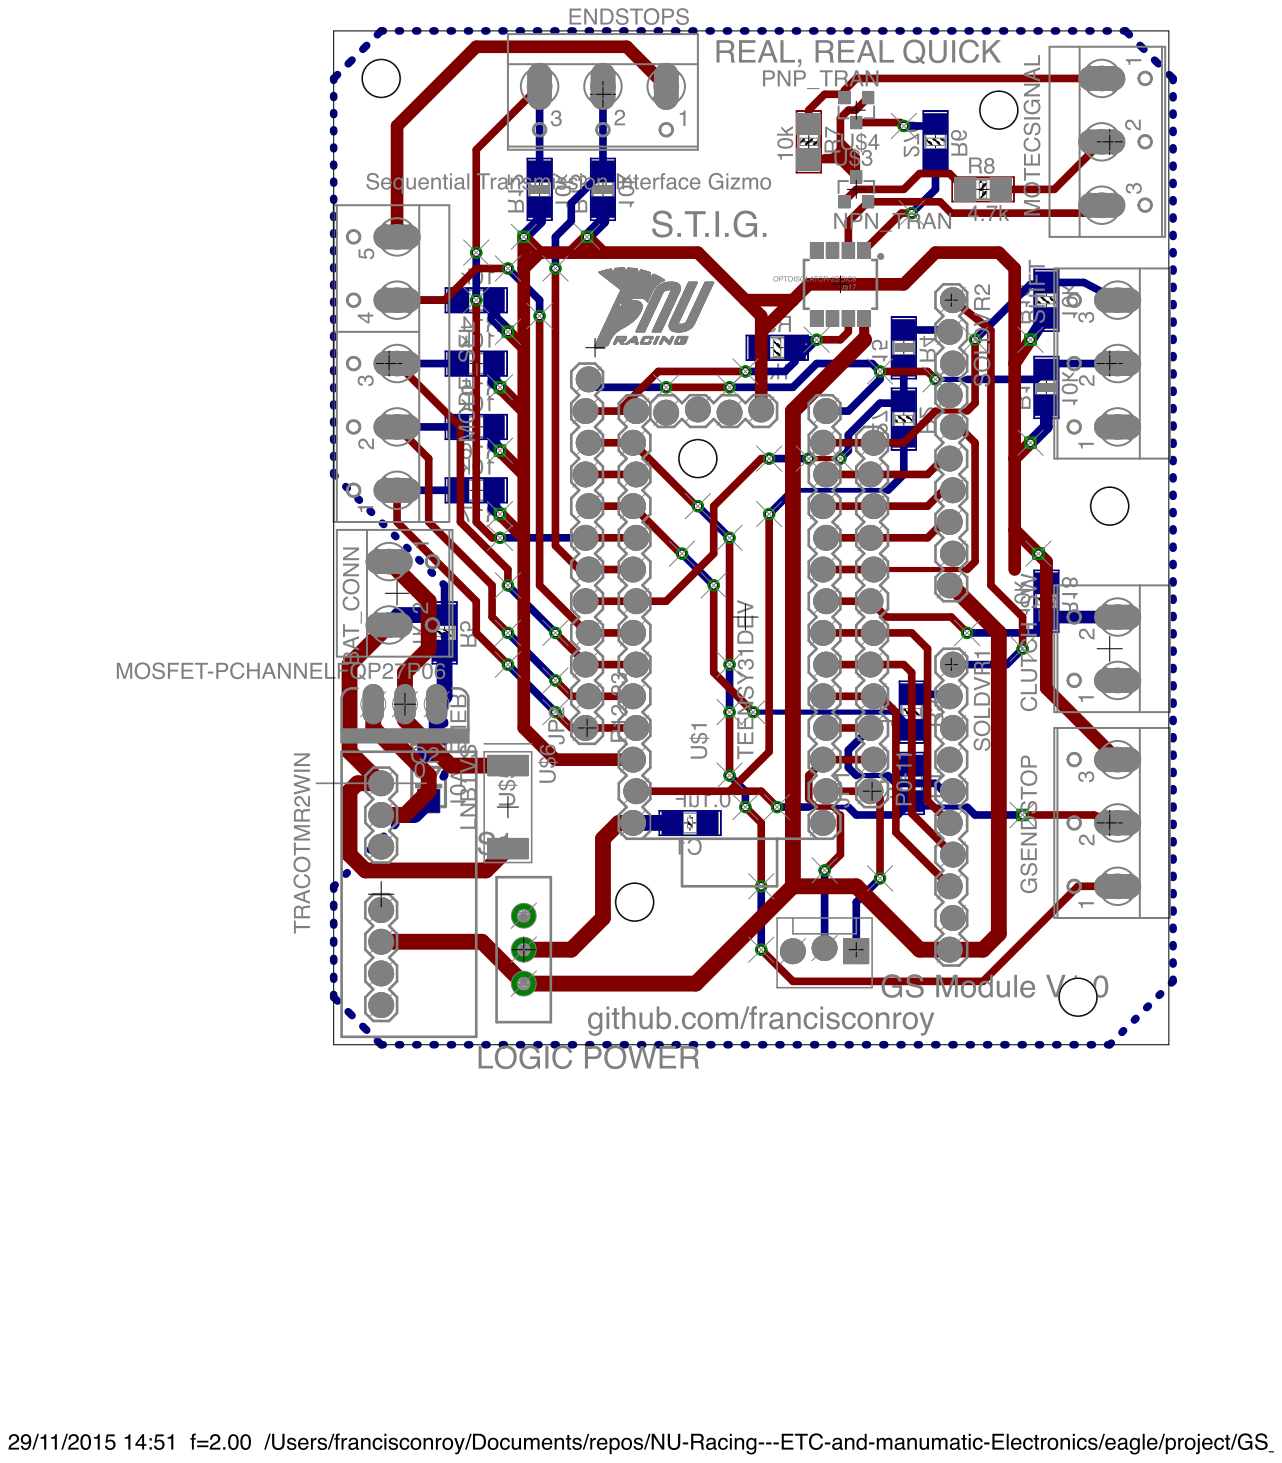
[picture p3: page 1]
