francisconroy/NU-Racing---ETC-and-manumatic-Electronics/eagle/project/ETC_module1.pdf

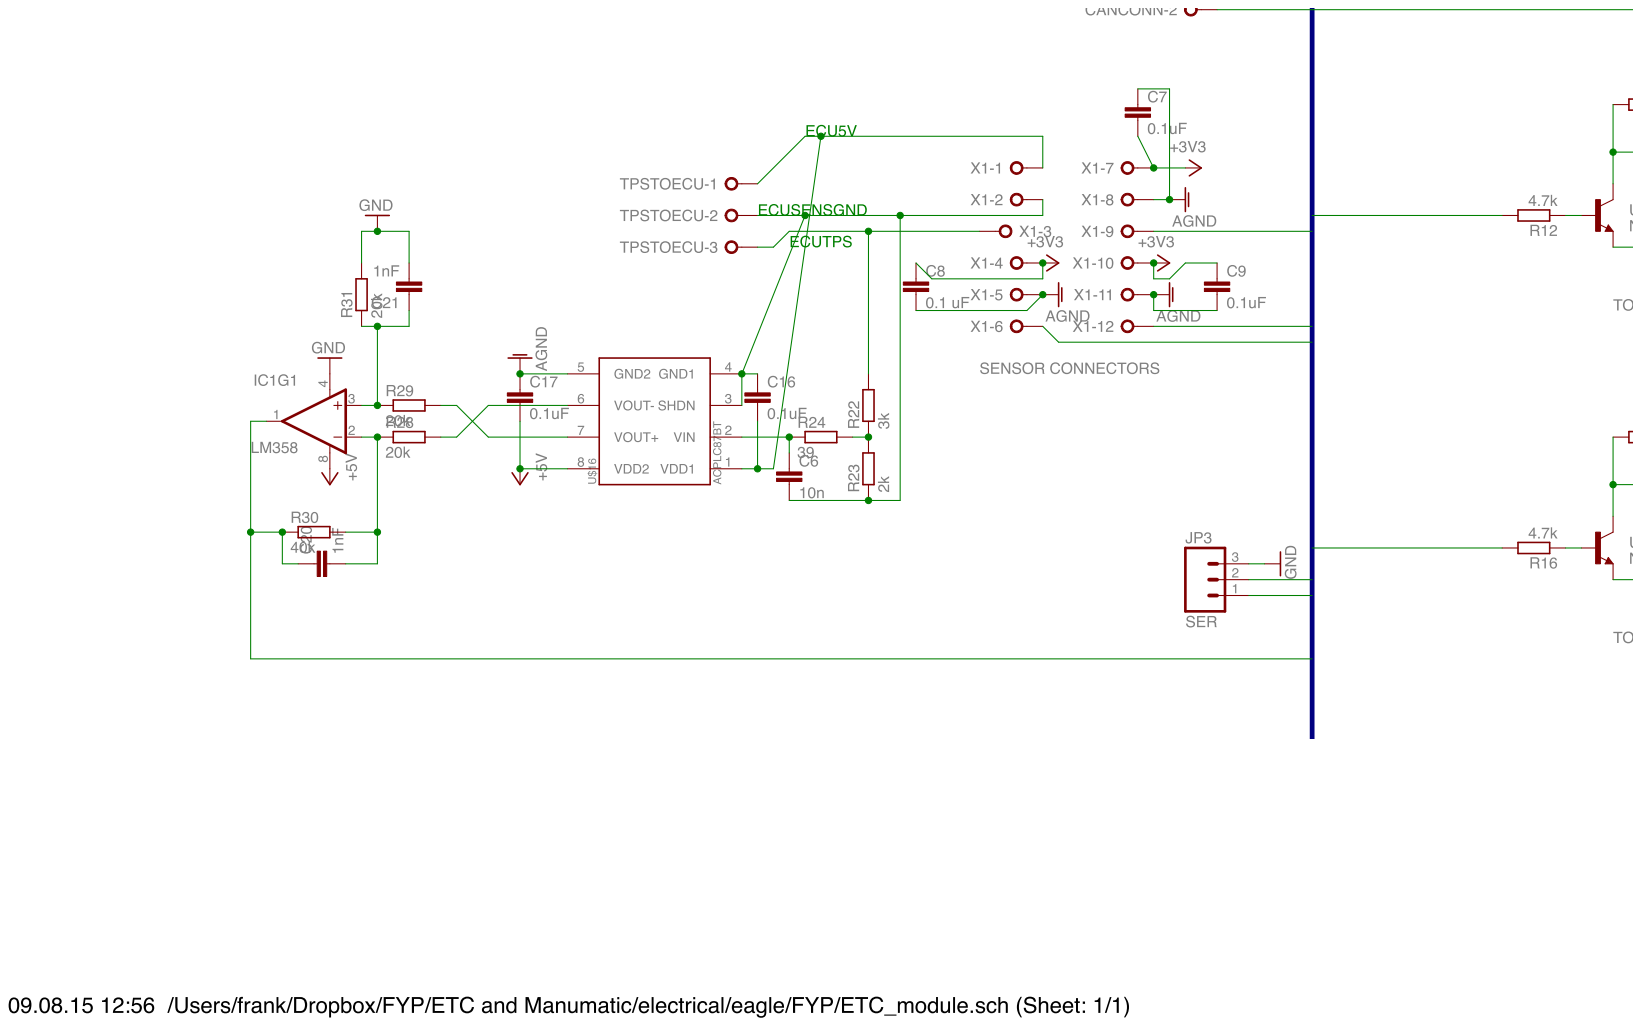
[picture p4: page 1]
