francisconroy/NU-Racing---ETC-and-manumatic-Electronics/eagle/project/ETC_module2.pdf

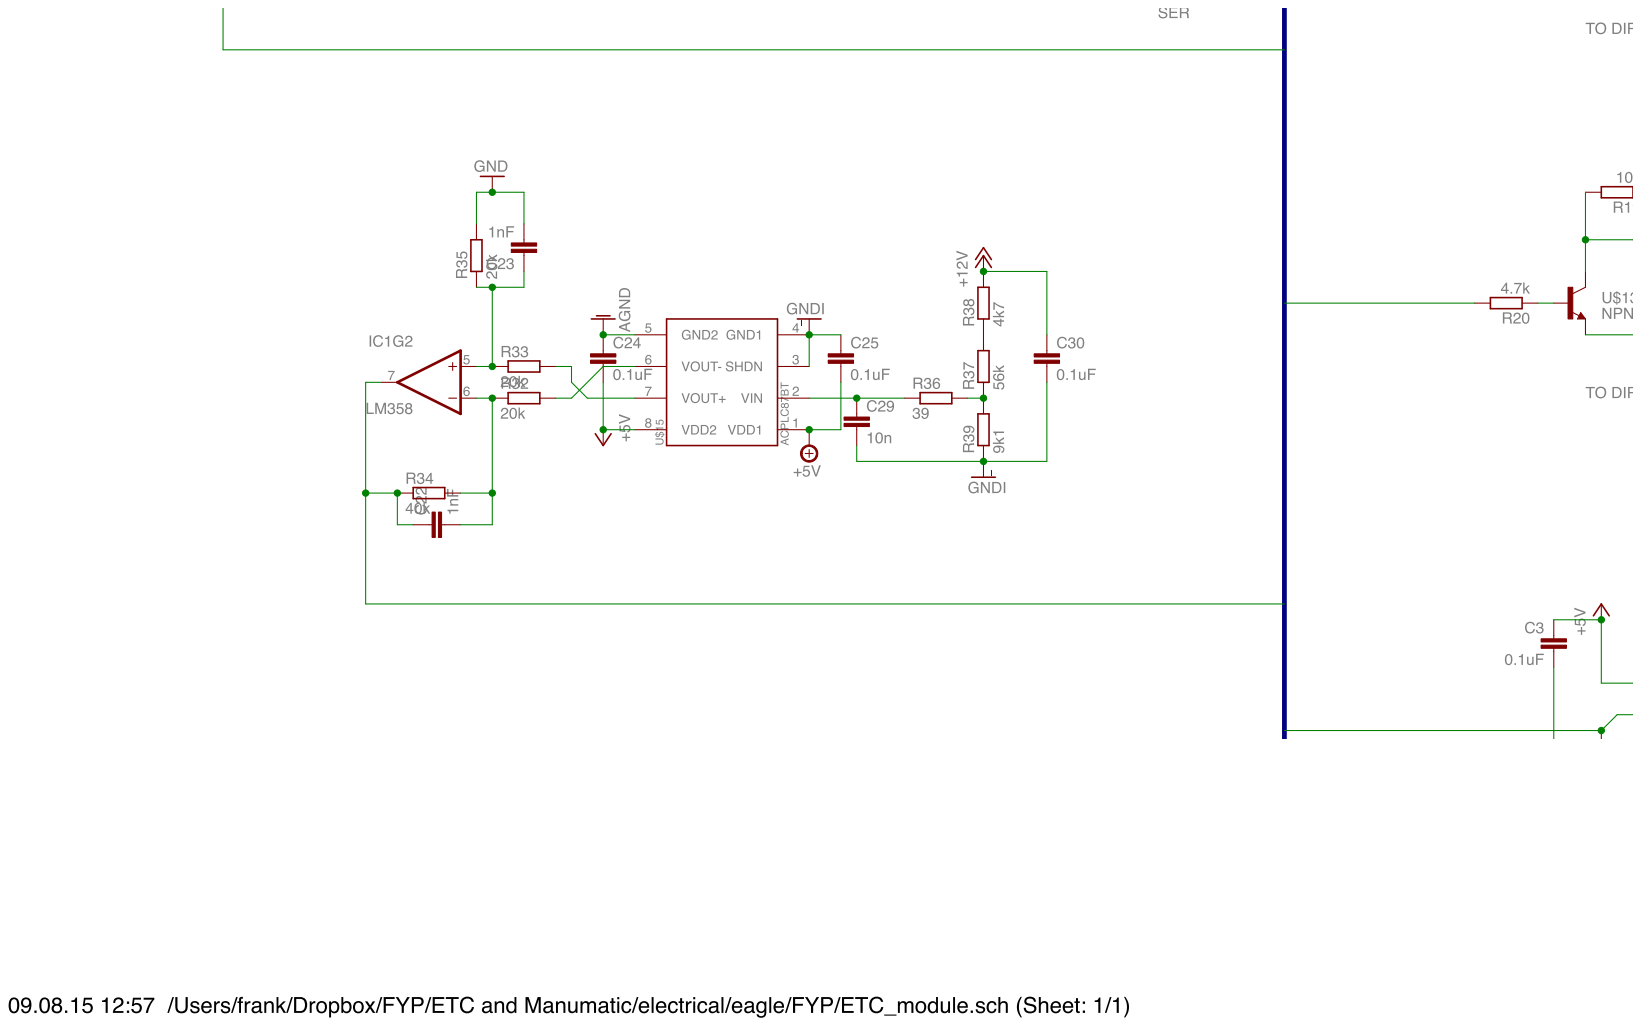
[picture p5: page 1]
