francisconroy/NU-Racing---ETC-and-manumatic-Electronics/eagle/project/ETC_module3.pdf

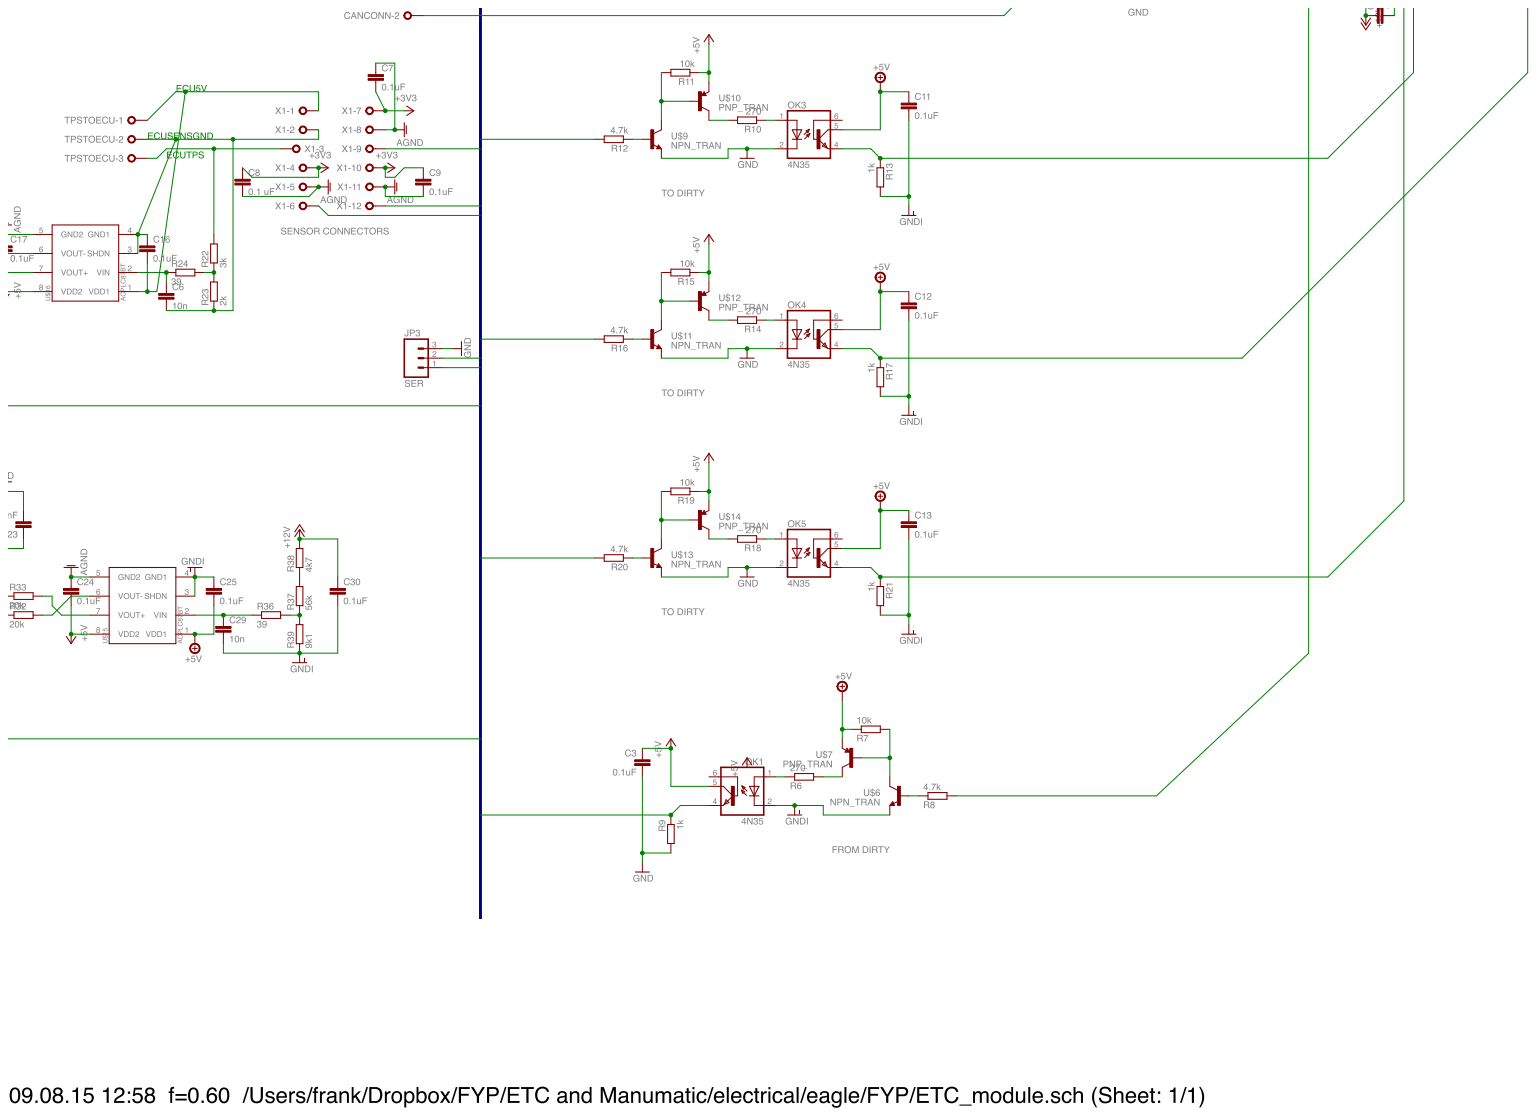
[picture p6: page 1]
