francisconroy/NU-Racing---ETC-and-manumatic-Electronics/starkey/solenoid_driver-master/pcb/dual_half_bridge_driver/driver.kicad_pcb

## KiCad design starkey/solenoid_driver-master/pcb/dual_half_bridge_driver/driver.kicad_pcb (2015-08-13)

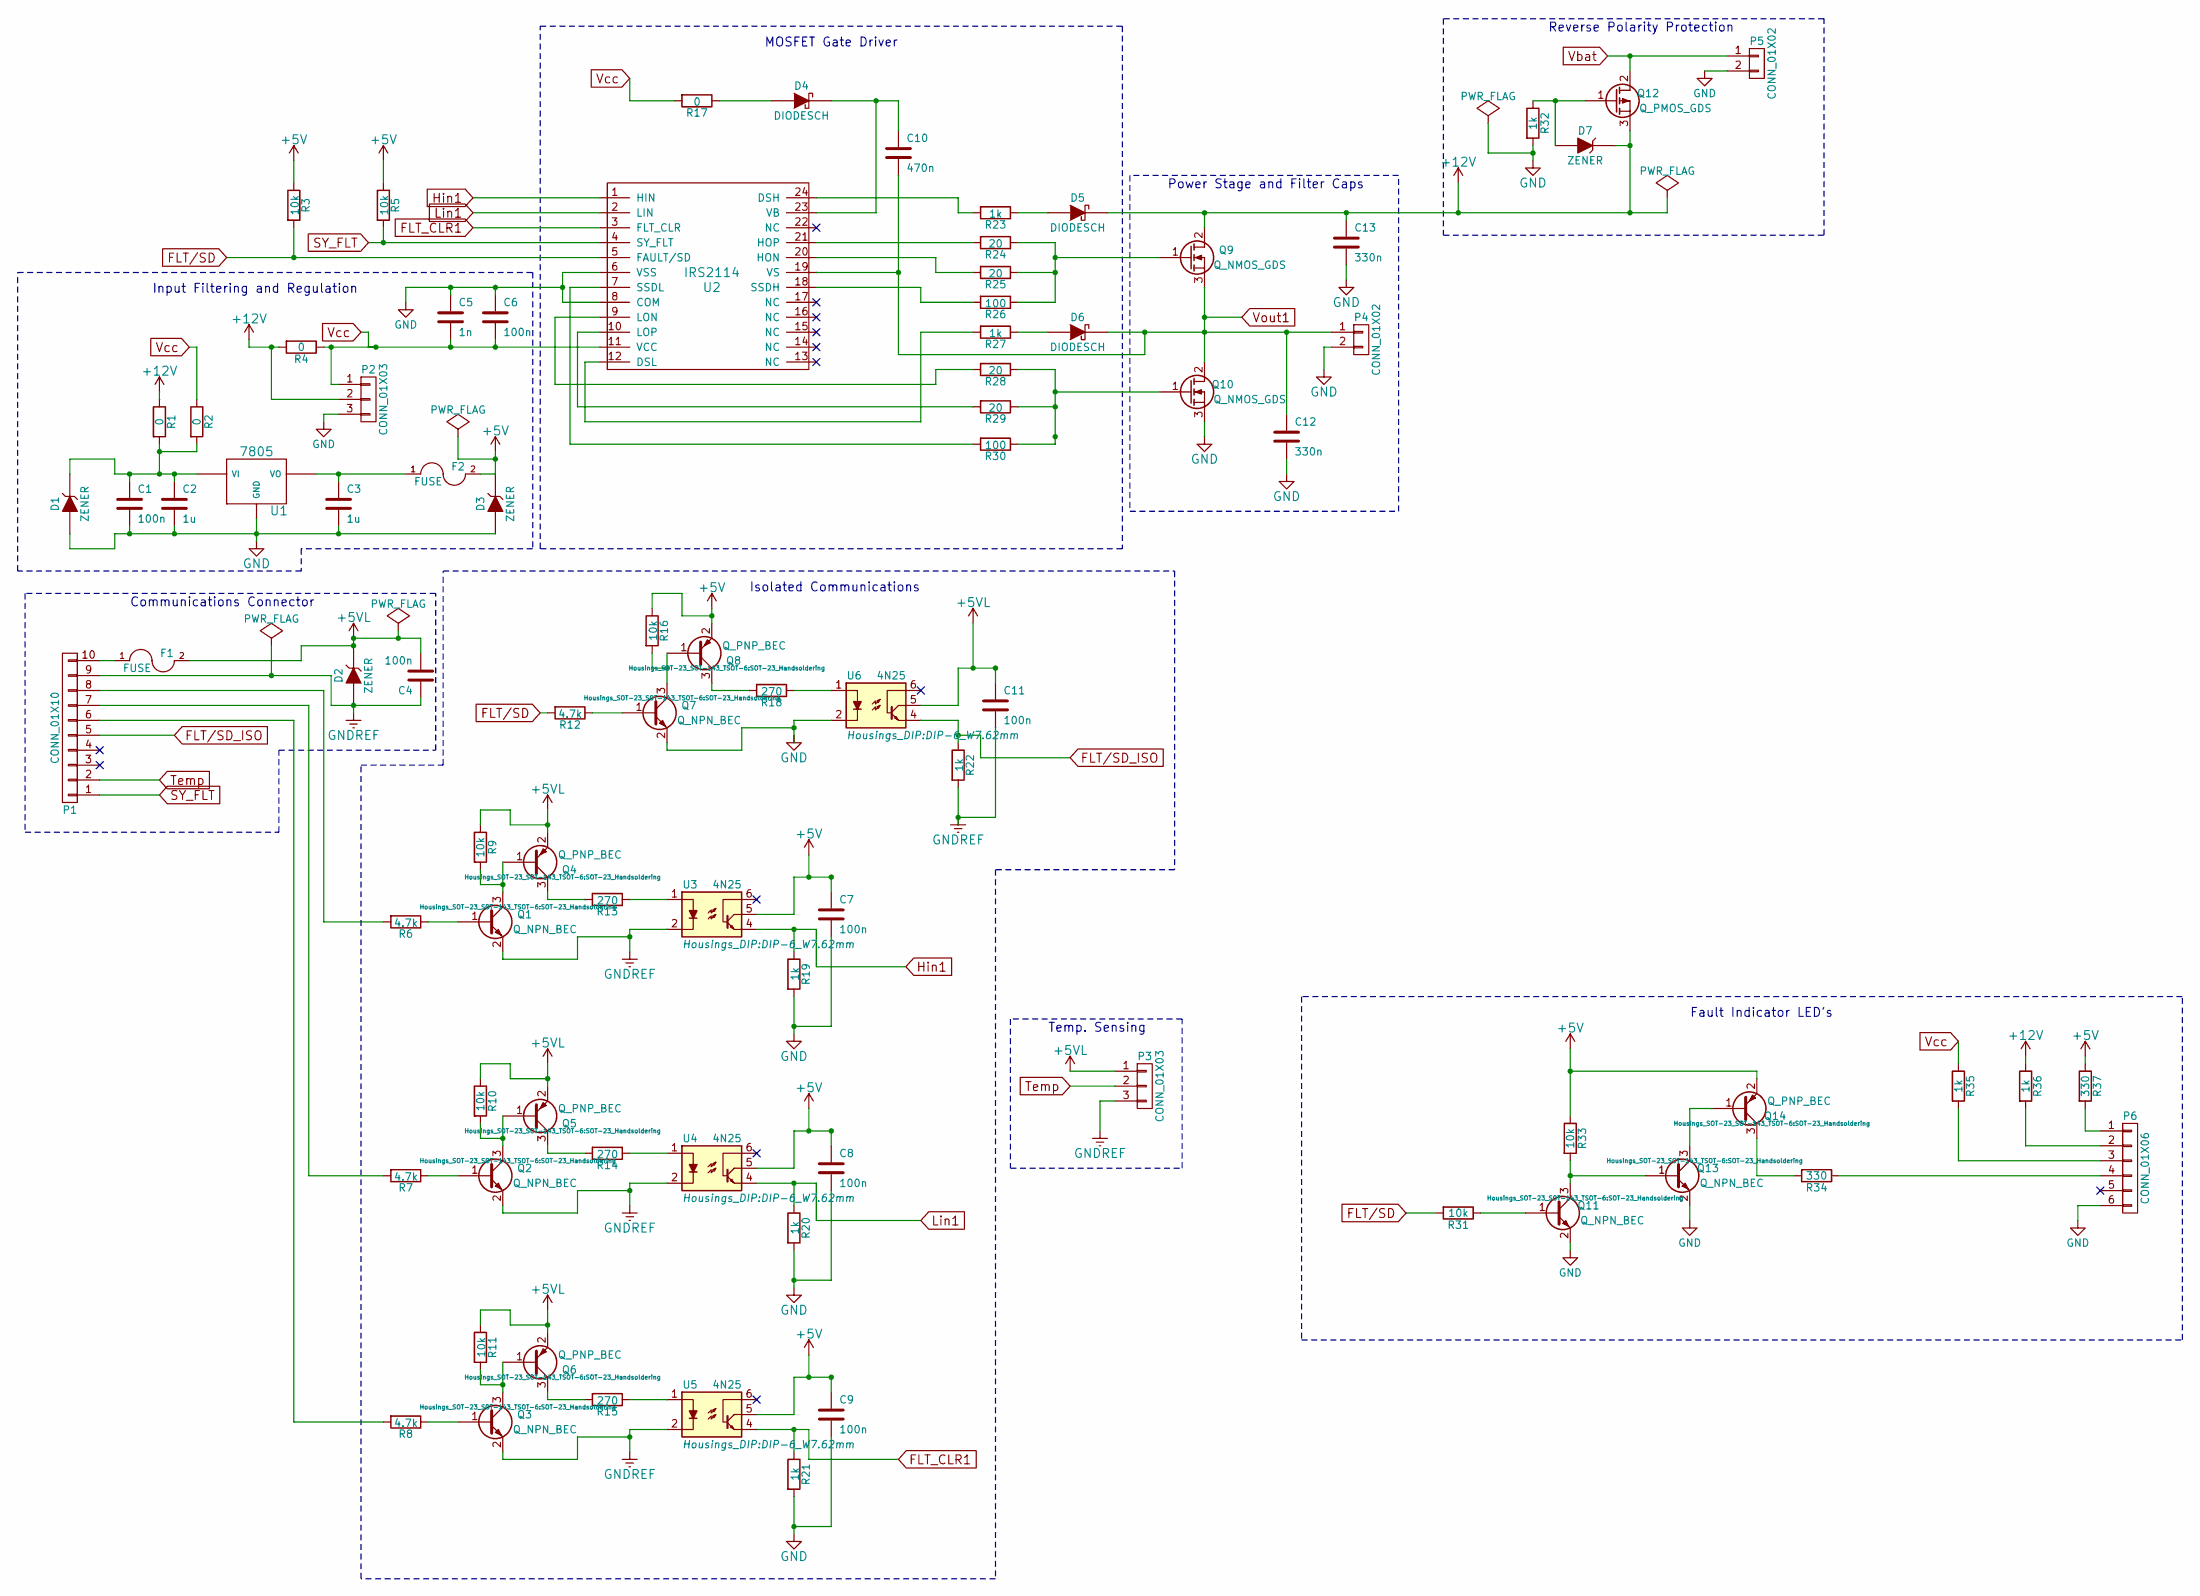
[picture p7: schematic driver.sch, Solenoid Driver]

Parts:
C1, C4, C6, C7, C8, C9, C11: 100n; C_1206_HandSoldering
C2, C3: 1u; C_1206_HandSoldering
C5: 1n; C_1206_HandSoldering
C10: 470n; C_1206_HandSoldering
C12: 330n; C_Rect_L32_W15_P27
C13: 330n; C_Rect_L18_W6_H12_P15
D1, D2, D3, D7: ZENER; SMD-1206_Pol
D4, D5, D6: DIODESCH; SMD-1206_Pol
F1, F2: FUSE; R_1206_HandSoldering
P1: CONN_01X10; Pin_Header_Straight_1x10
P2, P3: CONN_01X03; Pin_Header_Straight_1x03
P4: CONN_01X02; Pin_Header_Straight_1x02
P5: CONN_01X02; Crimp_Connector_2
P6: CONN_01X06; Pin_Header_Straight_1x06
Q1, Q2, Q3, Q7, Q11, Q13: Q_NPN_BEC; SOT-23_Handsoldering
Q4, Q5, Q6, Q8, Q14: Q_PNP_BEC; SOT-23_Handsoldering
Q9, Q10: Q_NMOS_GDS; TO-247_Vertical_Neutral123
Q12: Q_PMOS_GDS; TO-220_Neutral123_Vertical
R1, R2, R4, R17: 0; R_1206_HandSoldering
R3, R5, R9, R10, R11, R16, R31, R33: 10k; R_1206_HandSoldering
R6, R7, R8, R12: 4.7k; R_1206_HandSoldering
R13, R14, R15, R18: 270; R_1206_HandSoldering
R19, R20, R21, R22, R23, R27, R32, R35, R36: 1k; R_1206_HandSoldering
R24, R25, R28, R29: 20; R_1206_HandSoldering
R26, R30: 100; R_1206_HandSoldering
R34, R37: 330; R_1206_HandSoldering
U1: 7805; D-Pak_TO252AA
U2: IRS2114; SSOP-24_5.3x8.2mm_Pitch0.65mm
U3, U4, U5, U6: 4N25; DIP-6_W7.62mm

Connections:
+5V: C7.1, C8.1, C9.1, D3.2 (K), F2.2, Q8.2 (E), Q14.2 (E), R3.1, R5.1, R16.1, R33.1, R37.1, U3.5, U4.5, U5.5; also elsewhere on the board
+5VL: C4.2, C11.1, D2.2 (K), F1.2, P3.1, Q4.2 (E), Q5.2 (E), Q6.2 (E), R9.1, R10.1, R11.1, U6.5
+12V: C13.1, D5.2 (K), D7.2 (K), P2.2, Q9.2 (D), Q12.3 (S), R1.1, R4.2, R36.1
FLT/SD: R3.2, R12.2, R31.2, U2.5 (FAULT/SD)
FLT/SD_ISO: P1.5, R22.1, U6.4
FLT_CLR1: R21.1, U2.3 (FLT_CLR), U5.4
GNDREF: C4.1, C11.2, D2.1 (A), P1.9, P3.3, Q1.2 (E), Q2.2 (E), Q3.2 (E), R22.2, U3.2, U4.2, U5.2
Hin1: R19.1, U2.1 (HIN), U3.4
Lin1: R20.1, U2.2 (LIN), U4.4
unnamed: C1.1, C2.1, D1.2 (K), R1.2, R2.2, U1.1, U1.VI
unnamed: C3.1, F2.1, U1.3, U1.VO
unnamed: C10.1, D4.2 (K), U2.23 (VB)
unnamed: D4.1 (A), R17.1
unnamed: D5.1 (A), R23.1
unnamed: D6.1 (A), R27.1
unnamed: D7.1 (A), Q12.1 (G), R32.1
unnamed: F1.1, P1.10
unnamed: P1.6, R8.2
unnamed: P1.7, R7.2
unnamed: P1.8, R6.2
unnamed: P6.1, R37.2
unnamed: P6.2, R36.2
unnamed: P6.3, R35.2
unnamed: P6.4, R34.1
unnamed: Q1.1 (B), R6.1
unnamed: Q1.3 (C), Q4.1 (B), R9.2
unnamed: Q2.1 (B), R7.1
unnamed: Q2.3 (C), Q5.1 (B), R10.2
unnamed: Q3.1 (B), R8.1
unnamed: Q3.3 (C), Q6.1 (B), R11.2
unnamed: Q4.3 (C), R13.2
unnamed: Q5.3 (C), R14.2
unnamed: Q6.3 (C), R15.2
unnamed: Q7.1 (B), R12.1
unnamed: Q7.3 (C), Q8.1 (B), R16.2
unnamed: Q8.3 (C), R18.2
unnamed: Q9.1 (G), R24.1, R25.1, R26.1
unnamed: Q10.1 (G), R28.1, R29.1, R30.1
unnamed: Q11.1 (B), R31.1
unnamed: Q11.3 (C), Q13.1 (B), R33.2
unnamed: Q13.3 (C), Q14.1 (B)
unnamed: Q14.3 (C), R34.2
unnamed: R13.1, U3.1
unnamed: R14.1, U4.1
unnamed: R15.1, U5.1
unnamed: R18.1, U6.1
unnamed: R23.2, U2.24 (DSH)
unnamed: R24.2, U2.21 (HOP)
unnamed: R25.2, U2.20 (HON)
unnamed: R26.2, U2.18 (SSDH)
unnamed: R27.2, U2.12 (DSL)
unnamed: R28.2, U2.9 (LON)
unnamed: R29.2, U2.10 (LOP)
unnamed: R30.2, U2.7 (SSDL)
SY_FLT: P1.1, R5.2, U2.4 (SY_FLT)
Temp: P1.2, P3.2
Vbat: P5.1, Q12.2 (D)
Vcc: C5.2, C6.2, P2.1, R2.1, R4.1, R17.2, R35.1, U2.11 (VCC)
Vout1: C10.2, C12.1, D6.2 (K), P4.1, Q9.3 (S), Q10.2 (D), U2.19 (VS)

Notes on the sheet:
Fault Indicator LED's
MOSFET Gate Driver
Power Stage and Filter Caps
Reverse Polarity Protection
Input Filtering and Regulation
Isolated Communications
Communications Connector
Temp. Sensing

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
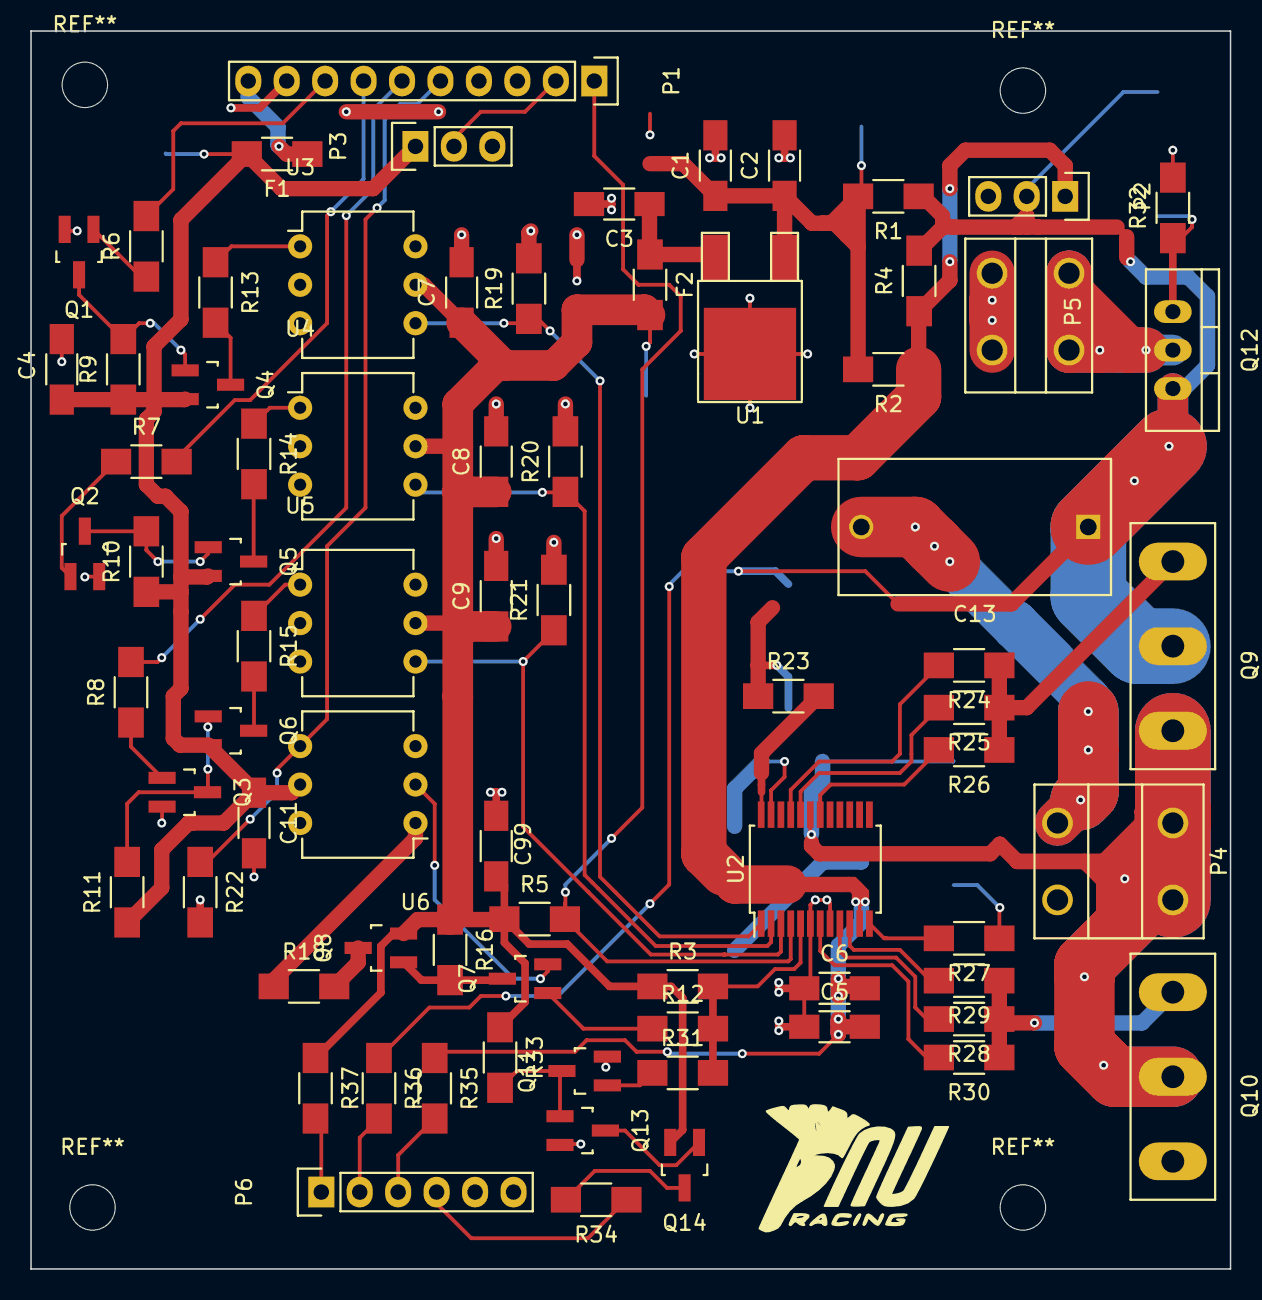
[picture p8: board driver.kicad_pcb from above]

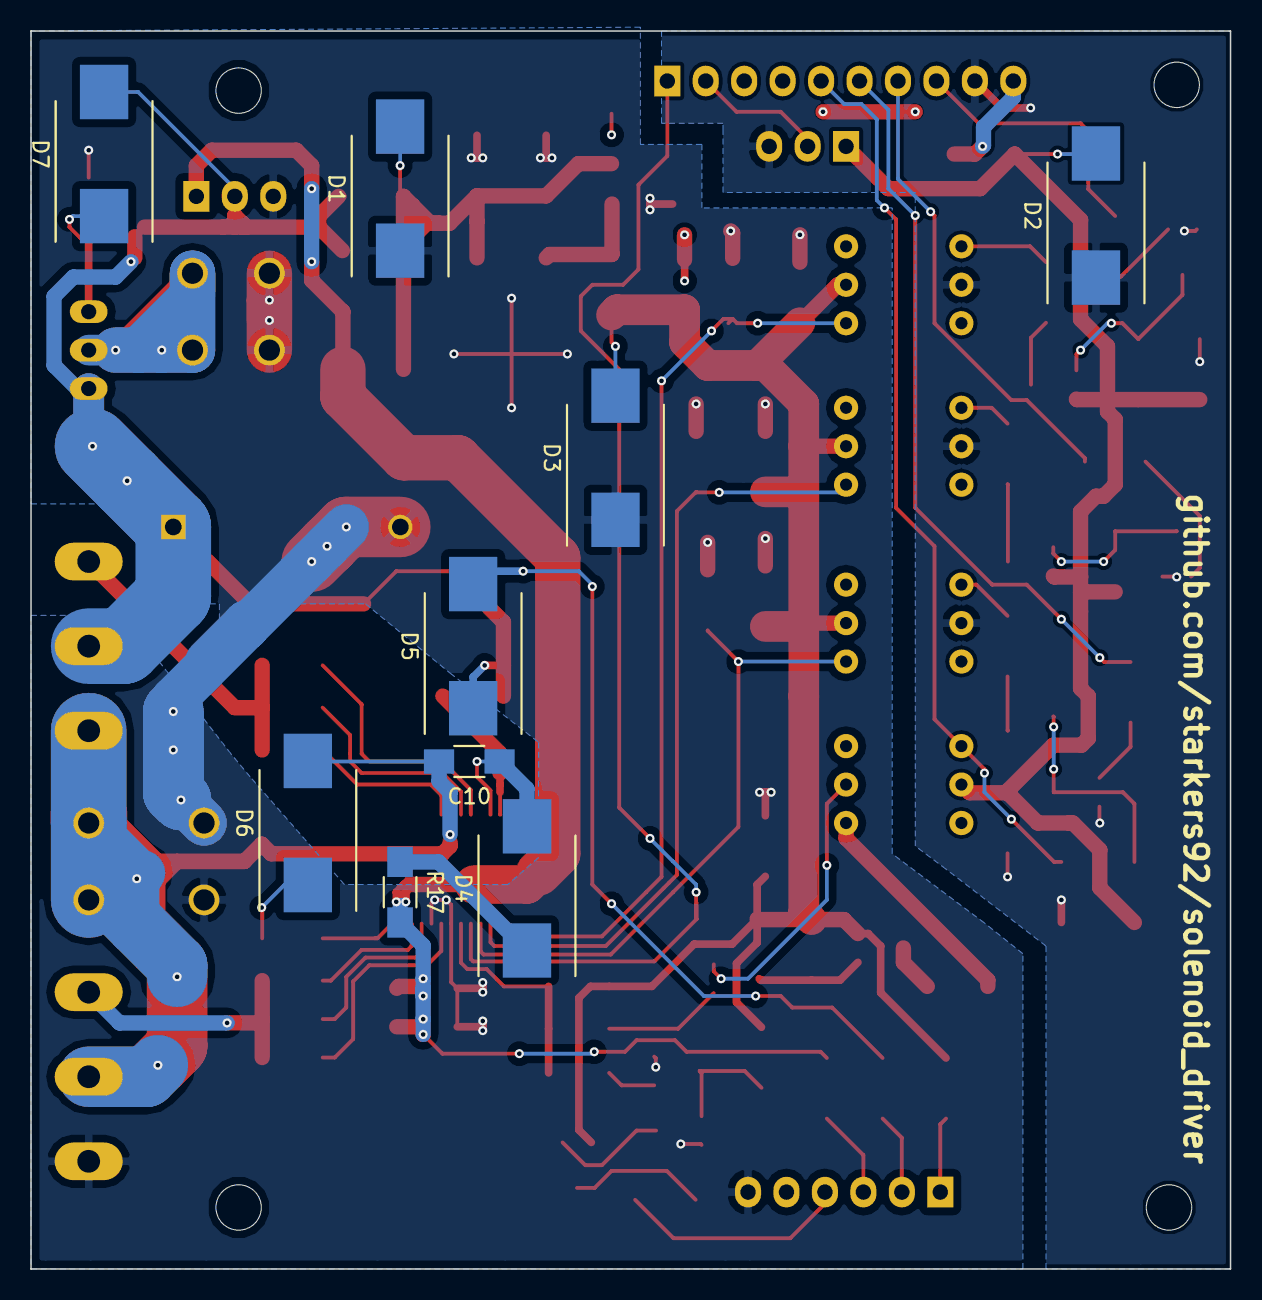
[picture p9: board driver.kicad_pcb from below]

Board: 2 copper layers, 79.2 x 81.8 mm, 85 parts (9 on the bottom side), 61 nets.

Other parts of the board:
C99: C_1206_HandSoldering

Their connections:
+5V: C99.1; also elsewhere on the board
