francisconroy/NU-Racing---ETC-and-manumatic-Electronics/eagle/project/ETC_module.brd

## EAGLE design eagle/project/ETC_module.brd (2015-12-18)

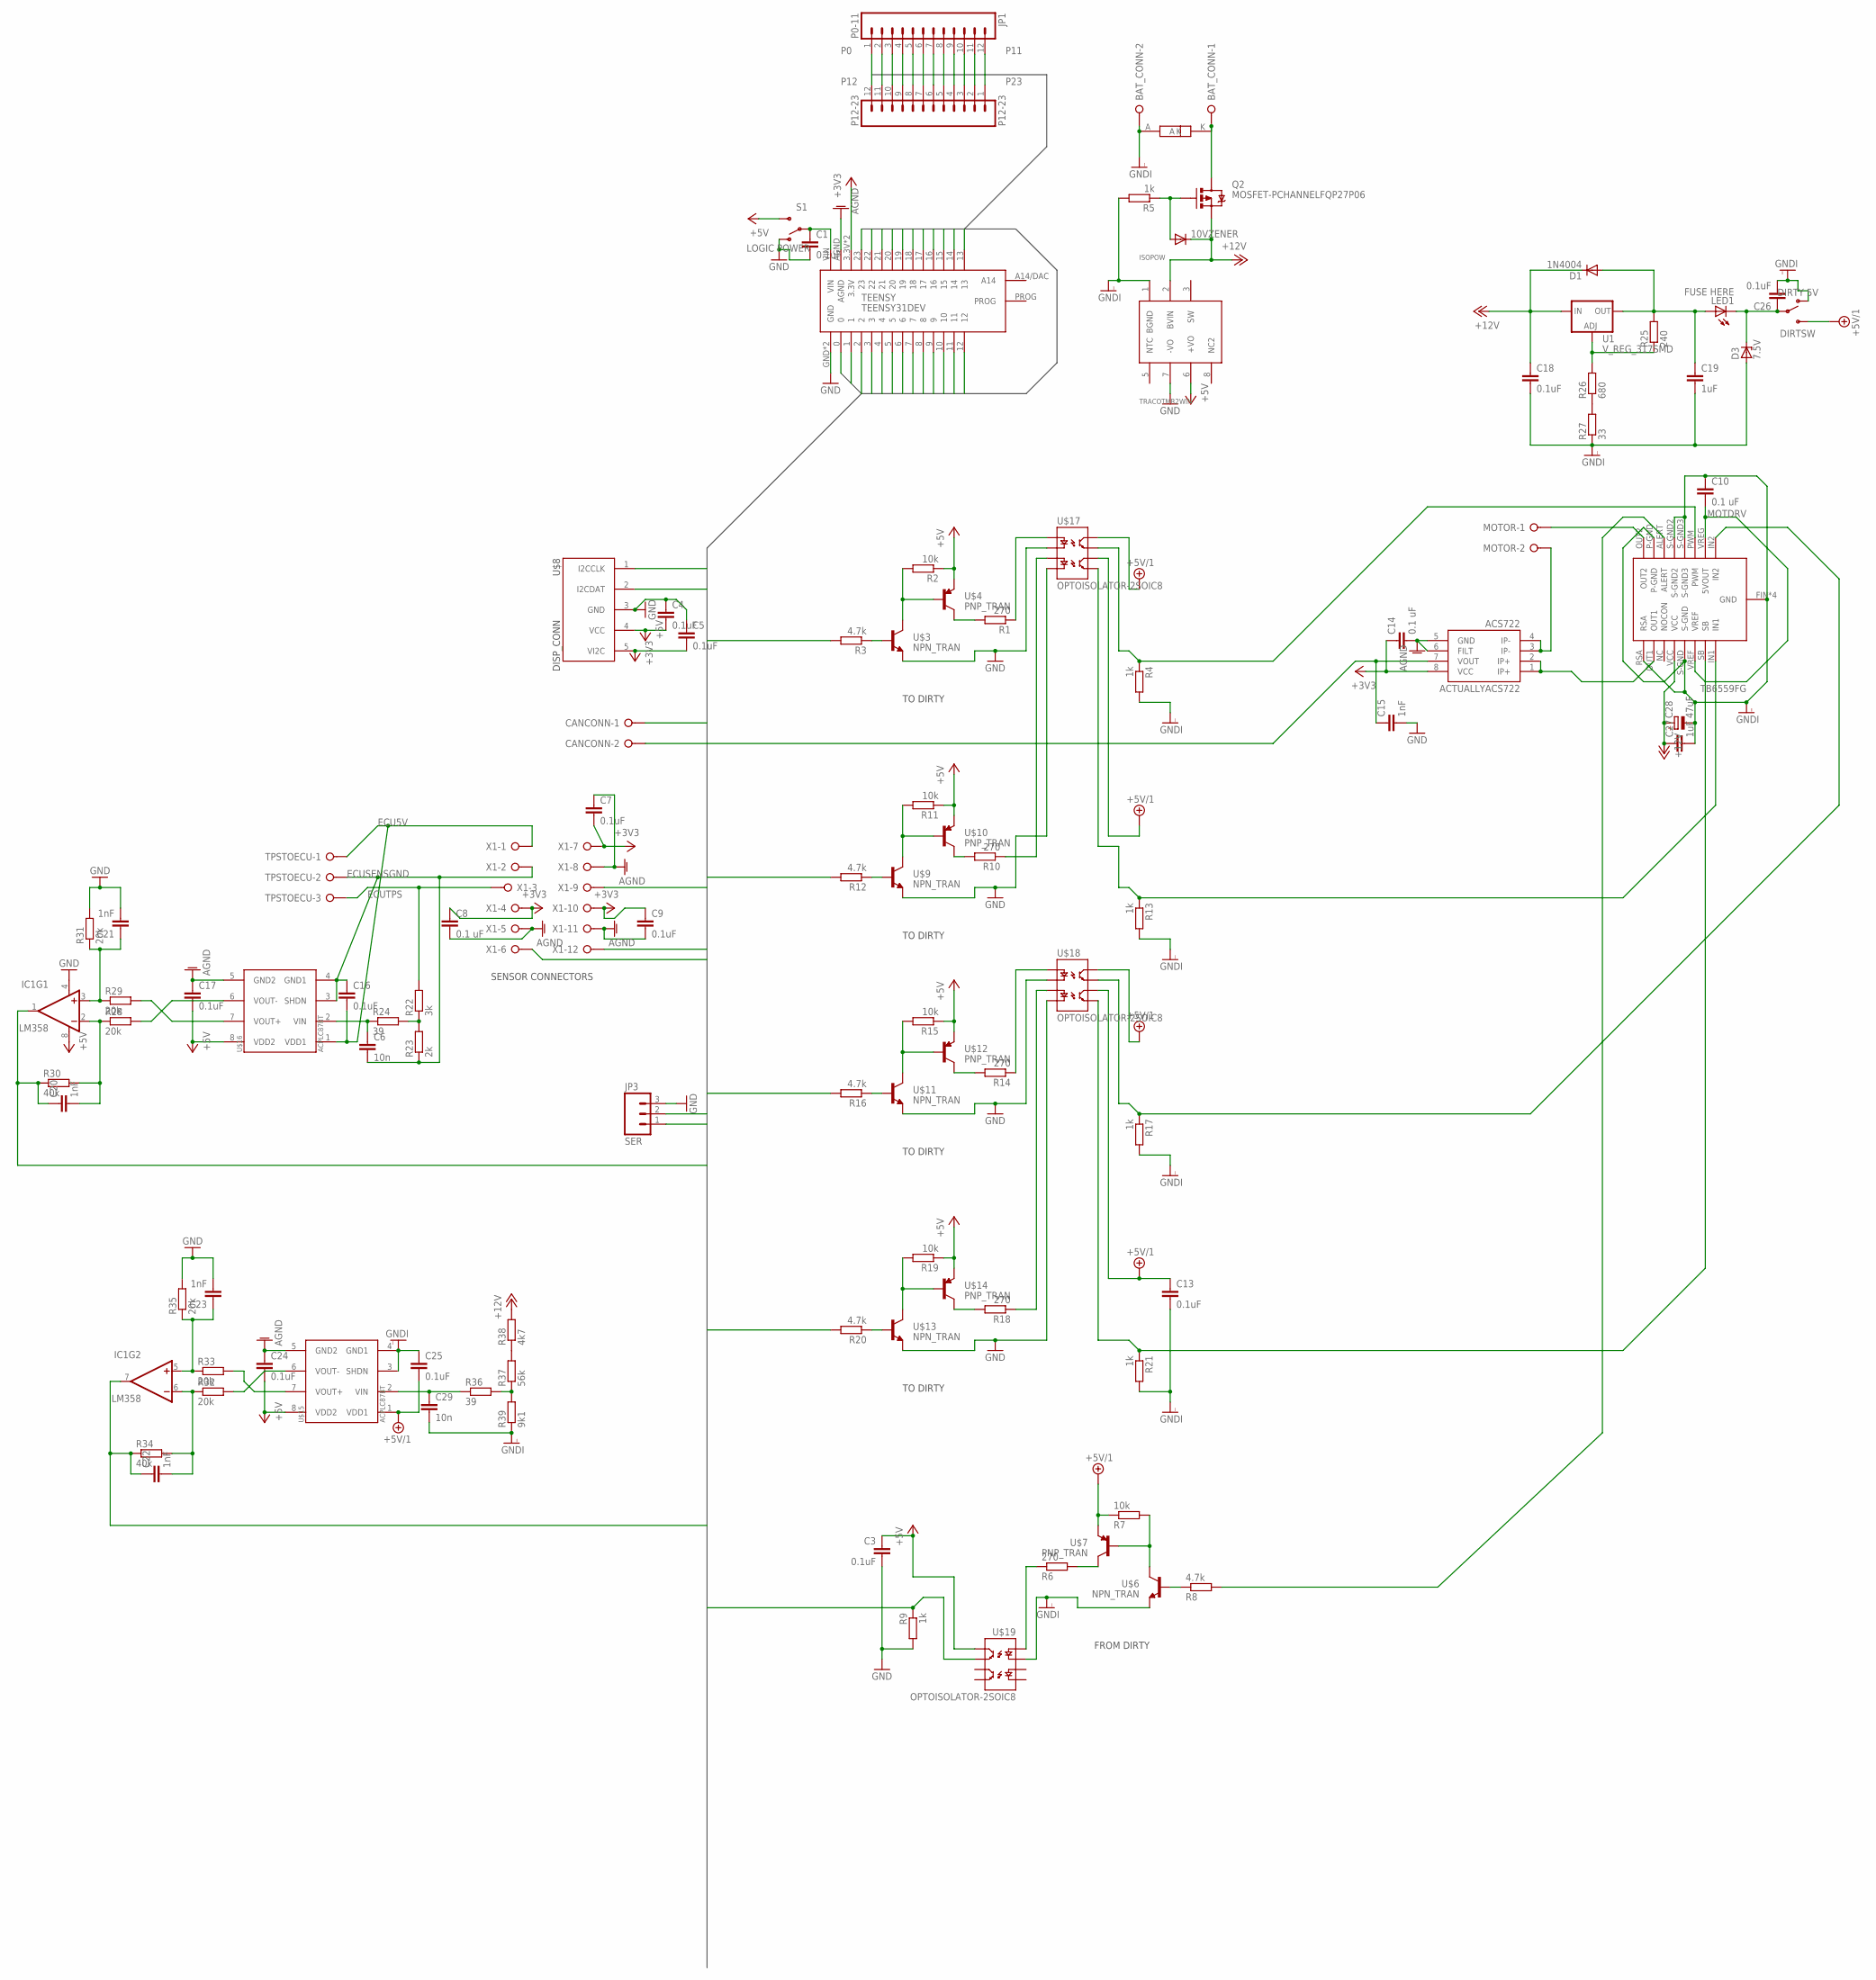
[picture p10: schematic ETC_module.sch]

Parts:
10VZENER: DIODE-DO214BA; DO214BA
ACTUALLYACS722: ACS722; SO08
BAT_CONN: W237-02P; W237-132
C1, C3, C4, C5, C7, C9, C13, C16, C17, C18, C24, C25, C26: 0.1uF; C1206
C6, C29: 10n; C1206
C8, C10, C14: 0.1 uF; C1206
C15, C20, C21, C22, C23: 1nF; C1206
C19, C27: 1uF; C1206
C28: 47uF; E5-8,5
CANCONN: W237-02P; W237-132
D1: 1N4004; DO41-10
D3: 7.5V; ZDIO-7.5
DIRTSW: DIRTY 5V; SWITCH-SPDT_KIT
IC1: LM358; DIP08
ISOPOW: TRACOTMR2WIN; TRACOPOWERDC-DCTRM2WIN
JP1: P0-11; 1X12_LOCK
JP3: SER; MOLEX-1X3_LOCK
LED1: FUSE HERE; LED-1206
MOTDRV: TB6559FG; HSOP16-P-300-1.00
MOTOR: W237-02P; W237-132
P12-23: P12-23; 1X12_LOCK
Q2: MOSFET-PCHANNELFQP27P06; TO220V
R1, R6, R10, R14, R18: 270; R1206
R2, R7, R11, R15, R19: 10k; R1206
R3, R8, R12, R16, R20: 4.7k; R1206
R4, R5, R9, R13, R17, R21: 1k; R1206
R22: 3k; M1206
R23: 2k; M1206
R24, R36: 39; R1206
R25: 240; R1206
R26: 680; R1206
R27: 33; R1206
R28, R29, R31, R32, R33, R35: 20k; R1206
R30, R34: 40k; R1206
R37: 56k; R1206
R38: 4k7; R1206
R39: 9k1; R1206
S1: LOGIC POWER; SWITCH-SPDT_KIT
TEENSY: TEENSY31DEV; TEENSY31PAC
TPSTOECU: W237-03P; W237-133
U1: V_REG_317SMD; SOT223
U$1: LNBTVS; JEDECDO-214AB
U$3, U$6, U$9, U$11, U$13: NPN_TRAN; SOT23-3
U$4, U$7, U$10, U$12, U$14: PNP_TRAN; SOT23-3
U$8: DISP_CONN
U$15, U$16: ACPLC87BT; SO8STRETCH
U$17, U$18, U$19: OPTOISOLATOR-2SOIC8; SO08-2
X1: W237-12P

Connections:
5VOUT: C10.2, MOTDRV.VREF, MOTDRV.VREG (5VOUT)
+3V3: ACTUALLYACS722.8 (VCC), C5.2, C7.2, C8.1, C9.1, C14.1, TEENSY.3.3V, TEENSY.3.3VV (3.3V), U$8.5 (VI2C), X1.4, X1.7, X1.10
+5V/1: C13.1, C25.2, DIRTSW.3 (S), R7.1, U$7.2 (E), U$15.1 (VDD1), U$17.6 (CL2), U$17.8 (CL1), U$18.6 (CL2), U$18.8 (CL1)
+5VCLEAN: C3.1, C4.2, C17.2, C24.2, IC1.8 (V+), ISOPOW.6 (+VO), R2.1, R11.1, R15.1, R19.1, S1.3 (S), U$4.2 (E), U$8.4 (VCC), U$10.2 (E), U$12.2 (E), U$14.2 (E), U$15.8 (VDD2), U$16.8 (VDD2), U$19.8 (CL1)
+12V: 10VZENER.C, C18.1, C27.1, C28.+, D1.C, ISOPOW.2 (BVIN), MOTDRV.VCC, Q2.3 (S), R38.2, U1.3 (IN)
AGND: ACTUALLYACS722.5 (GND), ACTUALLYACS722.6 (FILT), C7.1, C8.2, C9.2, C14.2, C17.1, C24.1, TEENSY.AGND, U$15.5 (GND2), U$16.5 (GND2), X1.5, X1.8, X1.11
ECU5V: C16.2, TPSTOECU.1, U$16.1 (VDD1), X1.1
ECUSENSGND: C6.2, C16.1, R23.1, TPSTOECU.2, U$16.3 (SHDN), U$16.4 (GND1), X1.2
ECUTPS: R22.2, TPSTOECU.3, X1.3
GND: C1.2, C3.2, C4.1, C5.1, C15.2, C21.2, C23.2, IC1.4 (V-), ISOPOW.7 (-VO), JP3.3, R9.2, R31.2, R35.2, S1.1 (O), TEENSY.GND, TEENSY.GND2 (GND), U$3.2 (E), U$8.3 (GND), U$9.2 (E), U$11.2 (E), U$13.2 (E), U$17.2 (C1), U$17.4 (C2), U$18.2 (C1), U$18.4 (C2)
GNDI: BAT_CONN.2, C10.1, C13.2, C18.2, C19.2, C25.1, C26.2, C27.2, C28.-, C29.2, D3.A, DIRTSW.1 (O), ISOPOW.1 (BGND), MOTDRV.FIN (GND), MOTDRV.FIN2 (GND), MOTDRV.P$4 (GND), MOTDRV.P$20 (GND), MOTDRV.P-GND, MOTDRV.RSA, MOTDRV.S-GND, MOTDRV.S-GND2, MOTDRV.S-GND3, R4.2, R5.2, R13.2, R17.2, R21.2, R27.1, R39.1, U$1.A, U$6.2 (E), U$15.3 (SHDN), U$15.4 (GND1), U$19.2 (C1)
unnamed: R2.2, U$3.3 (C), U$4.1 (B)
unnamed: C1.1, S1.2, TEENSY.VIN
unnamed: R1.1, U$17.1 (A1)
unnamed: R1.2, U$4.3 (C)
unnamed: R3.1, U$3.1 (B)
unnamed: R7.2, U$6.3 (C), U$7.1 (B)
unnamed: 10VZENER.A, Q2.1 (G), R5.1
unnamed: MOTDRV.PWM, R4.1, U$17.7 (EM1)
unnamed: R6.1, U$19.1 (A1)
unnamed: R6.2, U$7.3 (C)
unnamed: R8.1, U$6.1 (B)
unnamed: R19.2, U$13.3 (C), U$14.1 (B)
unnamed: R18.1, U$18.3 (A2)
unnamed: C26.1, D3.C, DIRTSW.2, LED1.C
unnamed: R37.2, R38.1
unnamed: C19.1, D1.A, LED1.A, R25.2, U1.2 (OUT)
unnamed: R11.2, U$9.3 (C), U$10.1 (B)
unnamed: MOTDRV.OUT2, MOTOR.1
unnamed: ACTUALLYACS722.1 (IP+), ACTUALLYACS722.2 (IP+), MOTDRV.OUT1
unnamed: R10.1, U$17.3 (A2)
unnamed: R10.2, U$10.3 (C)
unnamed: R12.1, U$9.1 (B)
unnamed: R15.2, U$11.3 (C), U$12.1 (B)
unnamed: R14.1, U$18.1 (A1)
unnamed: R14.2, U$12.3 (C)
unnamed: R16.1, U$11.1 (B)
unnamed: MOTDRV.IN2, R17.1, U$18.7 (EM1)
unnamed: R18.2, U$14.3 (C)
unnamed: R20.1, U$13.1 (B)
unnamed: MOTDRV.ALERT, R8.2
unnamed: MOTDRV.SB, R21.1, U$18.5 (EM2)
unnamed: ACTUALLYACS722.3 (IP-), ACTUALLYACS722.4 (IP-), MOTOR.2
unnamed: C6.1, R24.1, U$16.2 (VIN)
unnamed: R22.1, R23.2, R24.2
unnamed: R26.1, R27.2
unnamed: R25.1, R26.2, U1.1 (ADJ)
unnamed: R36.2, R37.1, R39.2
unnamed: C23.1, IC1.5 (+IN), R33.1, R35.1
unnamed: C22.2, IC1.6 (-IN), R32.1, R34.2
unnamed: R32.2, U$15.6 (VOUT-)
unnamed: MOTDRV.IN1, R13.1, U$17.5 (EM2)
unnamed: R29.2, U$16.7 (VOUT+)
unnamed: C21.1, IC1.3 (+IN), R29.1, R31.1
unnamed: C20.2, IC1.2 (-IN), R28.1, R30.2
unnamed: R28.2, U$16.6 (VOUT-)
unnamed: C29.1, R36.1, U$15.2 (VIN)
unnamed: R33.2, U$15.7 (VOUT+)
unnamed: BAT_CONN.1, Q2.2 (D), U$1.K
P0: JP1.1, JP3.1, TEENSY.0
P1: JP1.2, JP3.2, TEENSY.1
P2: JP1.3, TEENSY.2
P3: CANCONN.1, JP1.4, TEENSY.3
P4: CANCONN.2, JP1.5, TEENSY.4
P5: JP1.6, R9.1, TEENSY.5, U$19.7 (EM1)
P6: JP1.7, R3.2, TEENSY.6
P7: JP1.8, R12.2, TEENSY.7
P8: JP1.9, R16.2, TEENSY.8
P9: JP1.10, R20.2, TEENSY.9
P10: JP1.11, TEENSY.10
P11: JP1.12, TEENSY.11
P12: P12-23.12, TEENSY.12
P13: P12-23.11, TEENSY.13
P14: P12-23.10, TEENSY.14, X1.9
P15: P12-23.9, TEENSY.15, X1.12
P16: C20.1, IC1.1 (OUT), P12-23.8, R30.1, TEENSY.16
P17: P12-23.7, TEENSY.17, X1.6
P18: P12-23.6, TEENSY.18, U$8.2 (I2CDAT)
P19: P12-23.5, TEENSY.19, U$8.1 (I2CCLK)
P20: P12-23.4, TEENSY.20
P21: C22.1, IC1.7 (OUT), P12-23.3, R34.1, TEENSY.21
P22: ACTUALLYACS722.7 (VOUT), C15.1, P12-23.2, TEENSY.22
P23: P12-23.1, TEENSY.23

Notes on the sheet:
TO DIRTY
FROM DIRTY
SENSOR CONNECTORS

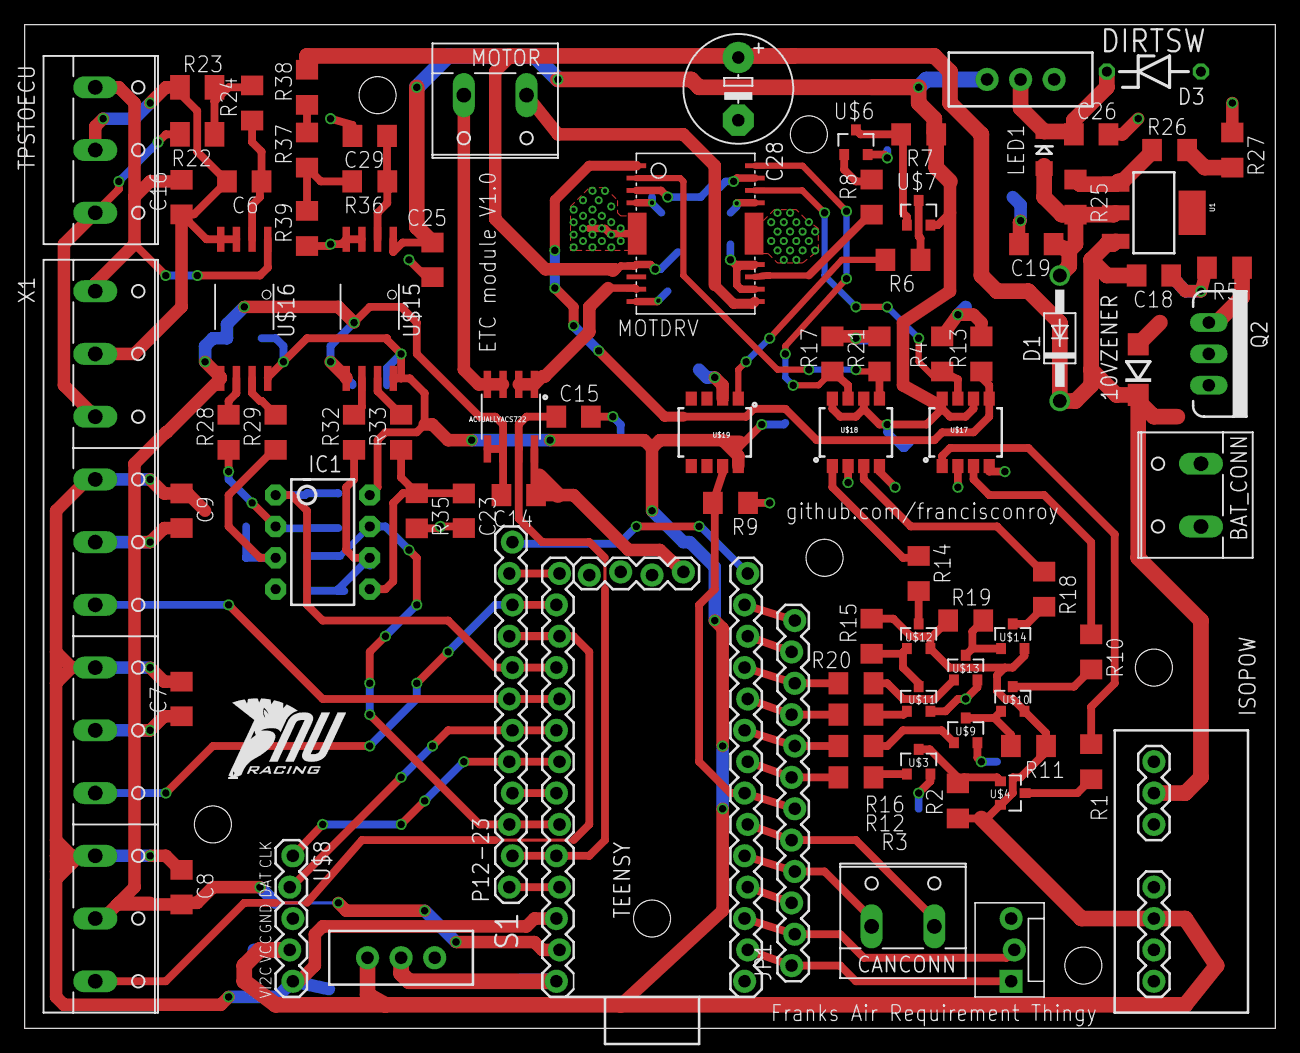
[picture p11: board ETC_module.brd from above]

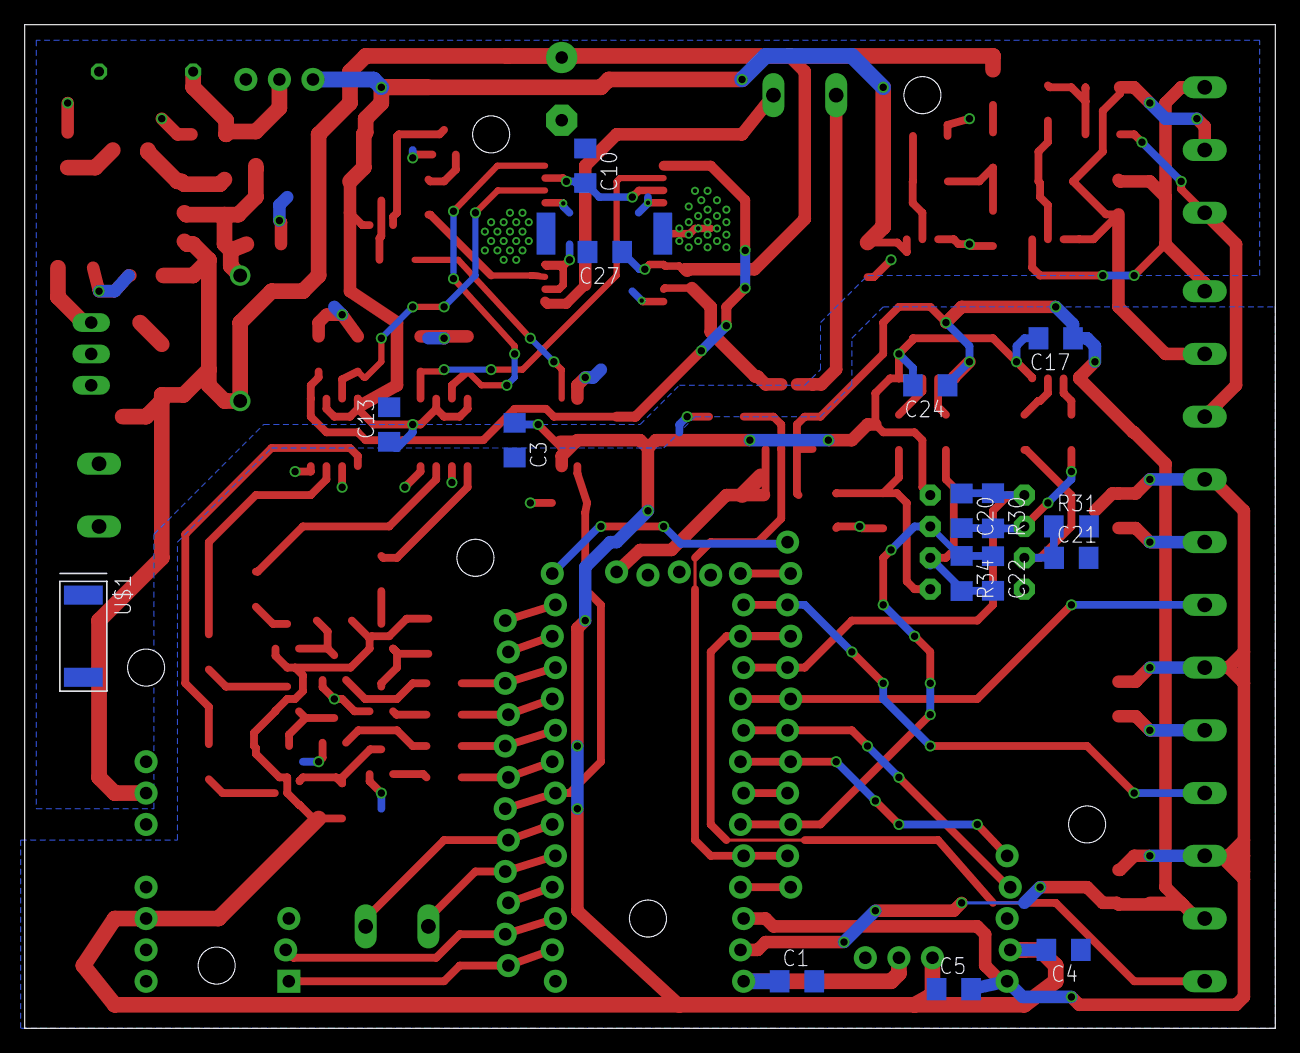
[picture p12: board ETC_module.brd from below]

Board: 2 copper layers, 101.3 x 81.3 mm, 104 parts (16 on the bottom side), 83 nets.

Other parts of the board:
U$20: NURLOGO
