francisconroy/NU-Racing---ETC-and-manumatic-Electronics/eagle/project/GS_module.brd

## EAGLE design eagle/project/GS_module.brd (2015-09-01)

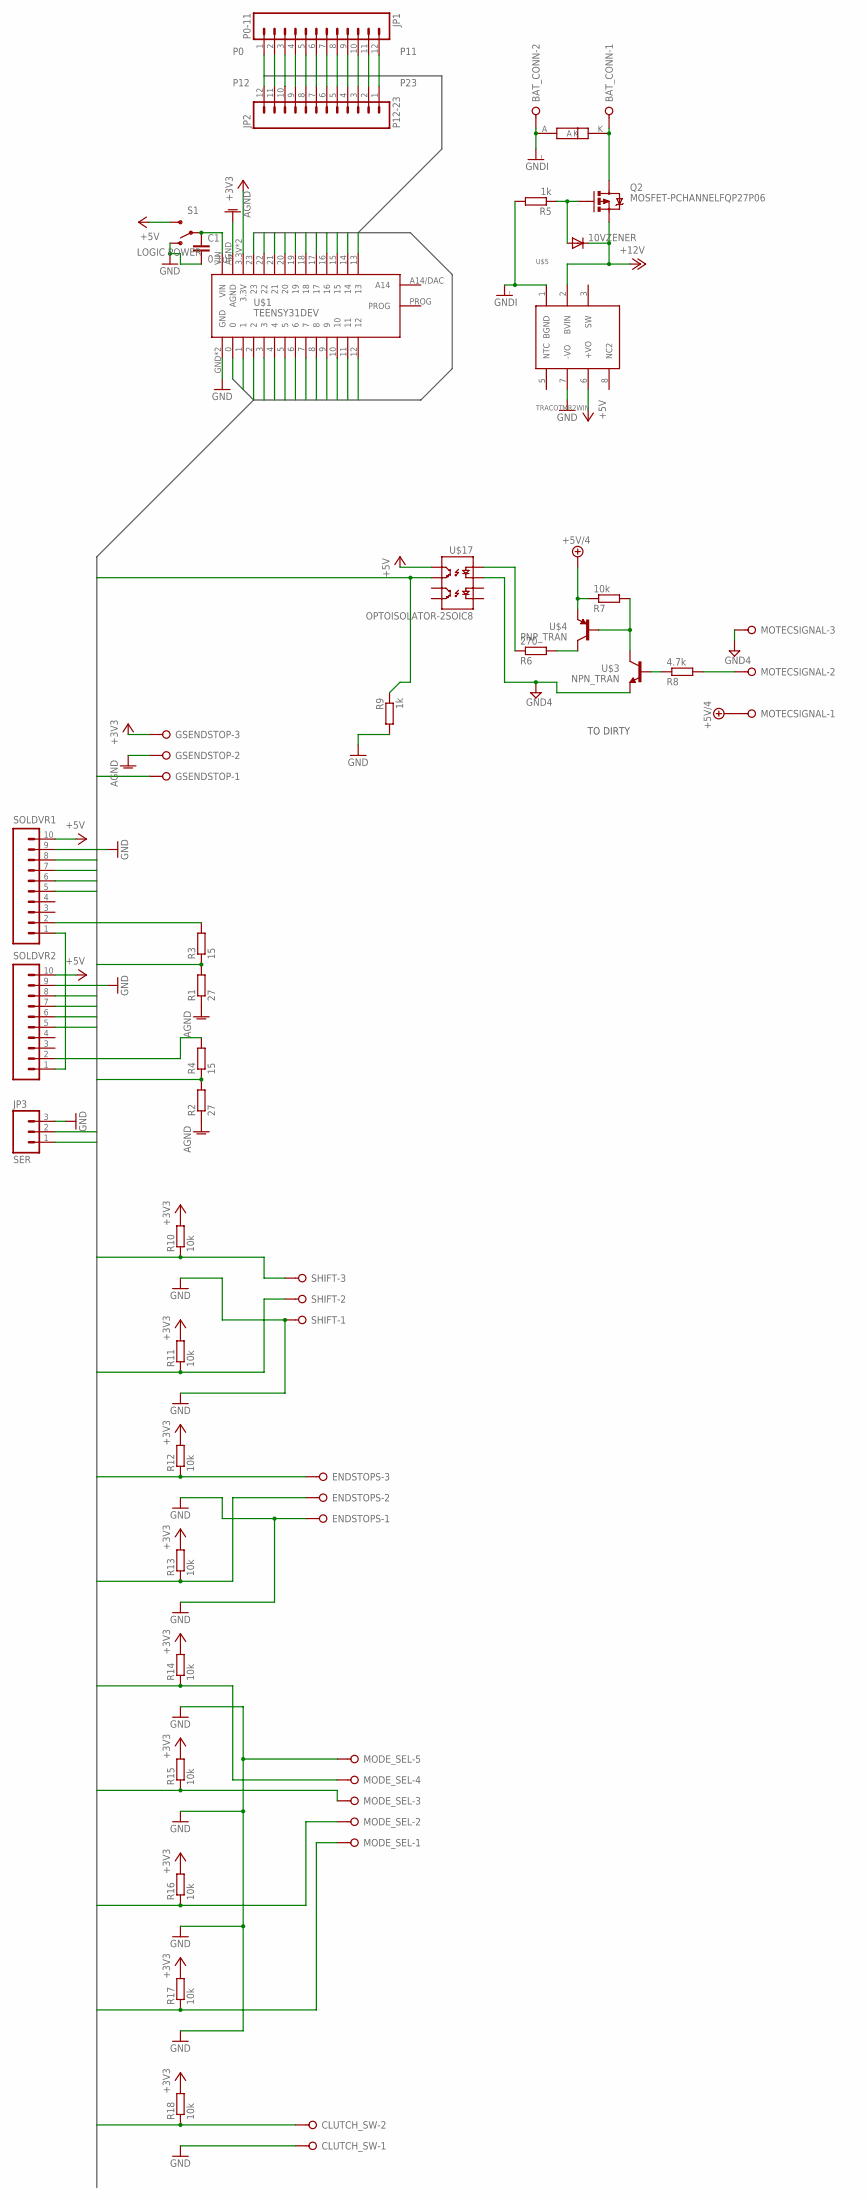
[picture p13: schematic GS_module.sch]

Parts:
10VZENER: DIODE-DO214BA; DO214BA
BAT_CONN: W237-02P; W237-132
C1: 0.1uF; C1206
CLUTCH_SW: W237-02P; W237-132
ENDSTOPS: W237-03P; W237-133
GSENDSTOP: W237-03P; W237-133
JP1: P0-11; 1X12_LOCK
JP2: P12-23; 1X12_LOCK
JP3: SER; MOLEX-1X3_LOCK
MODE_SEL: W237-05P; W237-5P
MOTECSIGNAL: W237-03P; W237-133
Q2: MOSFET-PCHANNELFQP27P06; TO220V
R1, R2: 27; R1206
R3, R4: 15; R1206
R5, R9: 1k; R1206
R6: 270; R1206
R7, R10, R11, R12, R13, R14, R15, R16, R17, R18: 10k; R1206
R8: 4.7k; R1206
S1: LOGIC POWER; SWITCH-SPDT_KIT
SHIFT: W237-03P; W237-133
SOLDVR1, SOLDVR2: M10LOCK; 1X10_LOCK
U$1: TEENSY31DEV; TEENSY31PAC
U$3: NPN_TRAN; SOT23-3
U$4: PNP_TRAN; SOT23-3
U$5: TRACOTMR2WIN; TRACOPOWERDC-DCTRM2WIN
U$6: LNBTVS; JEDECDO-214AB
U$17: OPTOISOLATOR-2SOIC8; SO08-2

Connections:
+3V3: GSENDSTOP.3, R10.2, R11.2, R12.2, R13.2, R14.2, R15.2, R16.2, R17.2, R18.2, U$1.3.3V, U$1.3.3VV (3.3V)
+5V: S1.3 (S), SOLDVR1.10, SOLDVR2.10, U$5.6 (+VO), U$17.8 (CL1)
+5V/4: MOTECSIGNAL.1, R7.1, U$4.2 (E)
+12V: 10VZENER.C, Q2.3 (S), U$5.2 (BVIN)
AGND: GSENDSTOP.2, R1.1, R2.1, U$1.AGND
GND: C1.2, CLUTCH_SW.1, ENDSTOPS.1, JP3.3, MODE_SEL.5, R9.2, S1.1 (O), SHIFT.1, SOLDVR1.9, SOLDVR2.9, U$1.GND, U$1.GND2 (GND), U$5.7 (-VO)
GND4: MOTECSIGNAL.3, U$3.2 (E), U$17.2 (C1)
GNDI: BAT_CONN.2, R5.2, U$5.1 (BGND), U$6.A
unnamed: R7.2, U$3.3 (C), U$4.1 (B)
unnamed: C1.1, S1.2, U$1.VIN
unnamed: R3.2, SOLDVR1.2
unnamed: R6.1, U$17.1 (A1)
unnamed: R4.2, SOLDVR2.2
unnamed: R6.2, U$4.3 (C)
unnamed: 10VZENER.A, Q2.1 (G), R5.1
unnamed: R8.1, U$3.1 (B)
unnamed: MOTECSIGNAL.2, R8.2
unnamed: SOLDVR1.1, SOLDVR2.1
unnamed: BAT_CONN.1, Q2.2 (D), U$6.K
P0: JP1.1, JP3.1, U$1.0
P1: JP1.2, JP3.2, U$1.1
P2: JP1.3, SOLDVR1.5, U$1.2
P3: JP1.4, SOLDVR1.8, U$1.3
P4: JP1.5, SOLDVR1.7, U$1.4
P5: JP1.6, SOLDVR1.6, U$1.5
P6: CLUTCH_SW.2, JP1.7, R18.1, U$1.6
P7: JP1.8, SOLDVR2.5, U$1.7
P8: JP1.9, SOLDVR2.8, U$1.8
P9: JP1.10, SOLDVR2.7, U$1.9
P10: JP1.11, SOLDVR2.6, U$1.10
P11: JP1.12, R10.1, SHIFT.3, U$1.11
P12: JP2.12, R11.1, SHIFT.2, U$1.12
P13: JP2.11, R9.1, U$1.13, U$17.7 (EM1)
P14: GSENDSTOP.1, JP2.10, U$1.14
P15: JP2.9, U$1.15
P16: JP2.8, R1.2, R3.1, U$1.16
P17: ENDSTOPS.3, JP2.7, R12.1, U$1.17
P18: ENDSTOPS.2, JP2.6, R13.1, U$1.18
P19: JP2.5, R2.2, R4.1, U$1.19
P20: JP2.4, MODE_SEL.4, R14.1, U$1.20
P21: JP2.3, MODE_SEL.3, R15.1, U$1.21
P22: JP2.2, MODE_SEL.2, R16.1, U$1.22
P23: JP2.1, MODE_SEL.1, R17.1, U$1.23

Notes on the sheet:
TO DIRTY

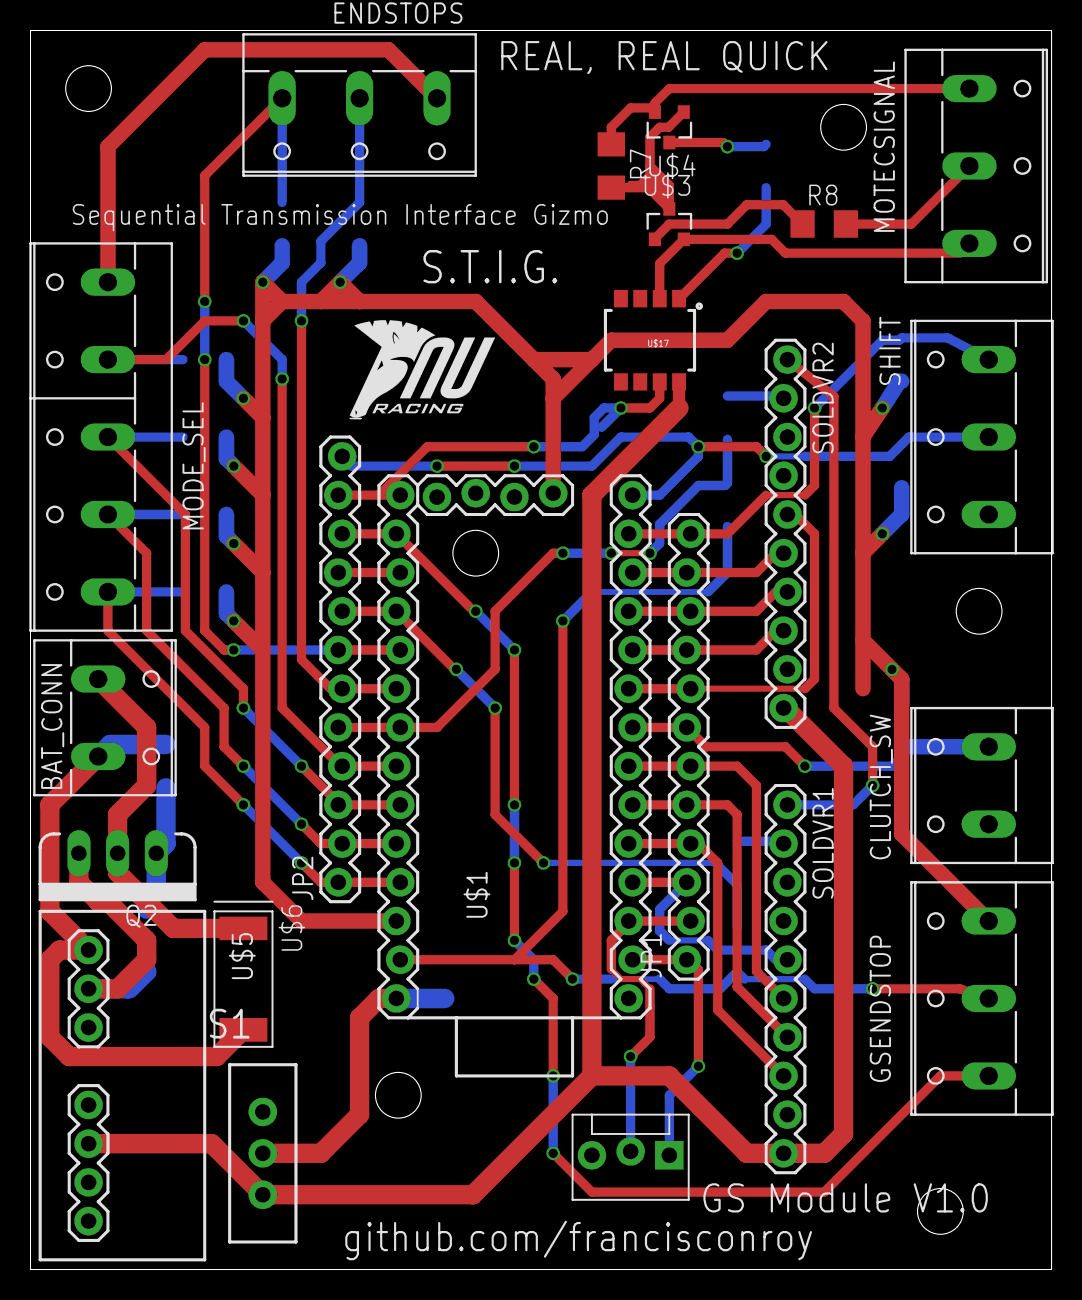
[picture p14: board GS_module.brd from above]

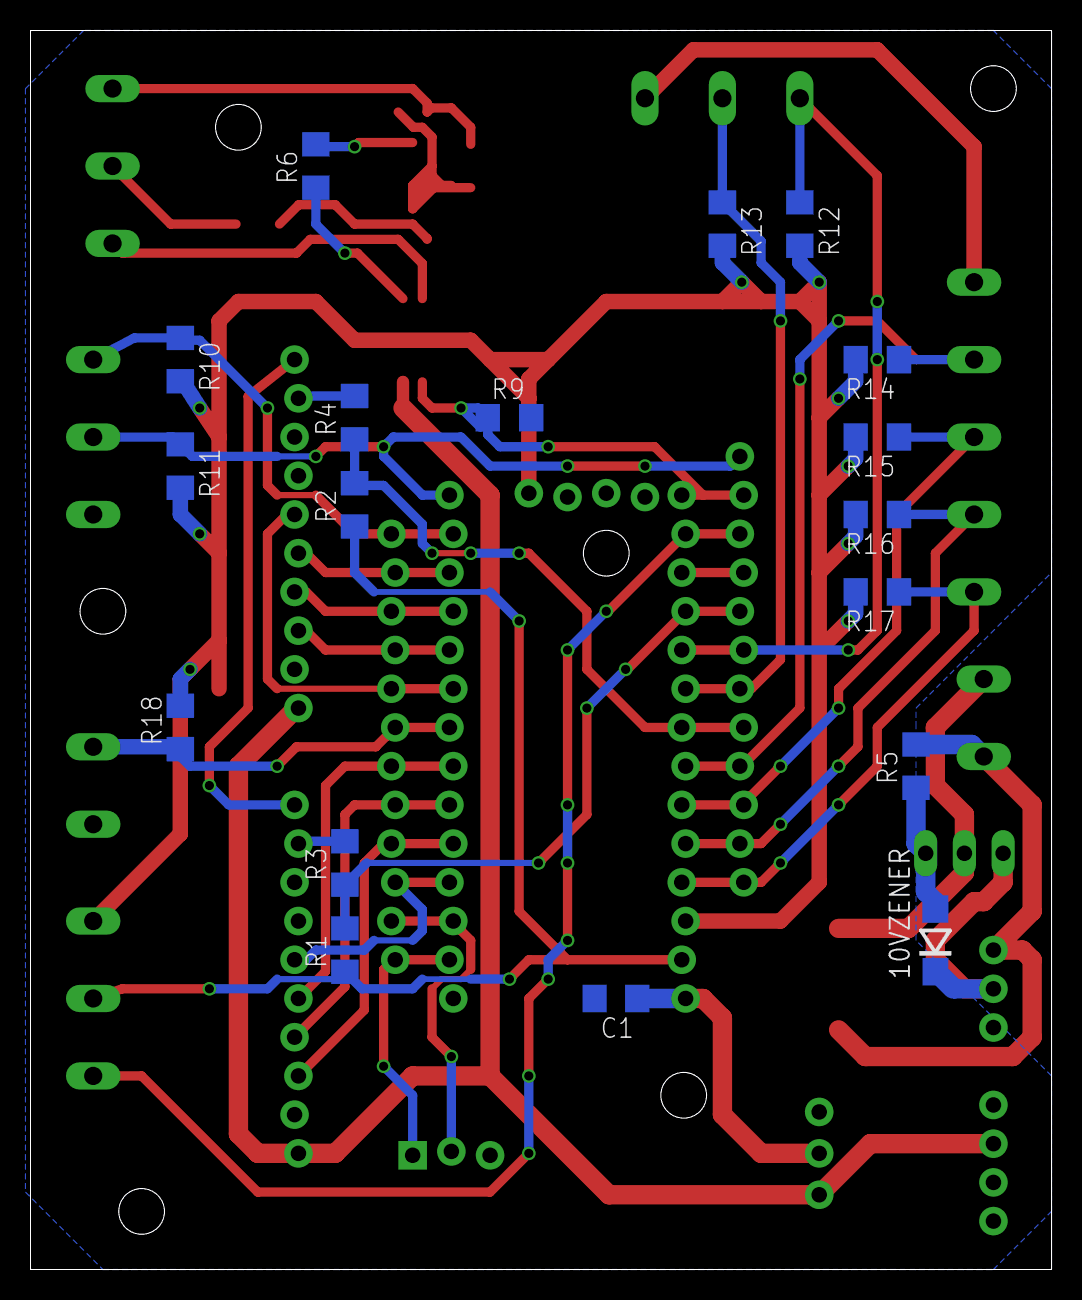
[picture p15: board GS_module.brd from below]

Board: 2 copper layers, 67.0 x 81.3 mm, 41 parts (18 on the bottom side), 43 nets.

Other parts of the board:
U$2: NURLOGO
