francisconroy/NU-Racing---ETC-and-manumatic-Electronics/(commit log)

2015-08-13 Initial commit to repo
    Commit ETC PCB layout as version 1.0
    [ETC module pin usage.xlsx, ETC_module.brd, ETC_module.sch, ETC_teensy.dwg, bill_of_materials.xlsx, bill_of_materials2.xlsx, calcs.xlsx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]
2015-08-16 v1.0 of ETC board complete
    initial work on GS board underway too
    [ETC_module.brd, ETC_module.sch, GS module pin usage.xlsx, GS_module.brd, GS_module.sch]
2015-08-19 finish version 1.0 of GS board
    yay!
    [ETC_module.brd, GS module pin usage.xlsx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]
2015-09-01 Versions of the board which went to the fab house
    Updating BOMS for component ordering
    [ETC module pin usage.xlsx, ETC_GS_Combined_BOM.xlsx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]
2015-09-01 more BOM work
    working on the BOMs
    [ETC_GS_Combined_BOM.xlsx]
2015-09-22 update
    make pdf
    [ETC_GS_Combined_BOM.xlsx, bill_of_materials2.xlsx]
2015-09-28 update for hardware construction
    [ETC module pin usage.xlsx, GS module pin usage.xlsx]
2015-10-09 update for connectors
    upd
    [wiring_connections.xlsx]
2015-10-15 update connectors
    [wiring_connections.xlsx]
2015-11-01 update at harness master
    update at harness master
    [new e14 order.xlsx, wiring_connections.xlsx]
2015-11-08 Update PINouts for testing
    update pinouts for new software developments
    [ETC module pin usage.xlsx, ETC_module.brd, GS module pin usage.xlsx]
2015-11-25 update to fix reverse polarity protection
    FLIP DS on FET, only done on ETC schematic
    [ETC module pin usage.xlsx, ETC_module.brd, ETC_module.sch, GS module pin usage.xlsx, _saved_driver.sch, wiring_connections.xlsx]
2015-12-01 Updates with wiring updates
    Woop
    [ETC module pin usage.xlsx, GS module pin usage.xlsx, _saved_driver.sch, bill_of_materials2.xlsx, toms driver connections.xlsx]
2015-12-18 update before comp
    Updates
    [ETC module pin usage.xlsx, ETC_module.brd, ETC_module.sch]
